ErdemWilkinson/makeshift-flipper/CAPABILITY_AND_THREAT_ASSESSMENT.md

# Makeshift Flipper: Capability, Use-Boundary, and Added-Component Impact Assessment

**Date:** 2026-09-21  
**Scope:** This document is a design and compliance assessment based on the
single-MCU ESP32-C6 firmware (UI + on-chip Wi-Fi/BLE radio) and the existing
hardware plans in this repository. It is not legal advice or an on-device
validation report.

> **Architecture note (2026-09-23):** The device was previously a two-chip
> design (ESP32-P4 main MCU + ESP32-C6 radio companion over UART). It is now
> a single ESP32-C6 running both the UI and the radio directly. References
> below to "the P4", "the C6 companion", or "the P4↔C6 UART link" describe the
> superseded design; in the current build those are one chip with no inter-MCU
> link, which removes the UART-boundary and cross-MCU-trust risks noted in
> those places rather than adding new ones.

## How to read this document

A capability is not inherently “legal” or “illegal.” The relevant factors are
authorization, purpose, data, target system, and local law. The
**inappropriate or potentially unlawful use** columns below are not feature
specifications or usage instructions. They record product risks and the
controls that should be put in place.

For this assessment, “authorized use” means at least:

- Owning the hardware, account, card, remote, or network, or having the
  owner's explicit and recorded permission;
- Defining the scope, timing, and data of a test in advance;
- Complying with personal-data, communications-privacy, access-control, and
  radio regulations;
- Sharing findings and logs only with authorized people and under secure
  retention conditions.

> **Validation warning:** Most features present in the code have not been
> validated on physical hardware. The firmware builds clean for the ESP32-C6,
> but the hardware has not been assembled — the ST7789 display wiring, the
> shared SPI bus, the RIGHT-button/I2C-SDA sharing, and Wi-Fi+BLE coexistence
> are all unverified. Therefore, “present” below means in code/design scope,
> not “working.”

## Six attention-worthy dual-use features

These are the six features most likely to make the device interesting to
makers, home-automation users, and authorized security testers. The last
column records the **unauthorized-use risk**, not a capability to promote or
implement. Hardware presence means “in the documented design”; it is not an
on-device success claim.

| Highlight | Legitimate, compelling use | Hardware/software basis | Unauthorized-use risk | Safe product framing |
|---|---|---|---|---|
| 1. Universal remote backup | Learn and replay an owner's compatible NEC TV, air-conditioner, or media remote from one handheld library | IR receiver, IR LED/transistor, NEC decoder/encoder, NVS library | Controlling compatible appliances without the owner's permission | “Your remotes only”; explicit send confirmation and visible transmit indicator. |
| 2. Test-card cloning lab | Demonstrate why weak MIFARE Classic default keys are unsafe, and back up owned training/test cards | RC522 reader/writer and constrained MIFARE Classic clone flow | Reusing an access credential to attempt unauthorized physical entry | Test cards and written authorization only; no persistent card dumps by default. |
| 3. Pocket wireless site survey | See nearby authorized Wi-Fi APs and BLE advertisers, with signal and channel information | On-chip ESP32-C6 Wi-Fi/BLE radios, passive monitor/scan UI | Collecting or profiling nearby networks/devices where there is no authority | Receive-only, short-lived display, no raw identifier saving by default. |
| 4. Offline field diagnostics | Carry errors and module status on-device for local debugging | On-device rolling error history (NVS) | Retaining scan/card data about people or networks with no authorization | On-device only; the old LAN log export is not part of the standalone build. |
| 5. No-phone Wi-Fi onboarding | Join an owned network by scanning and entering a password with the joystick keyboard, without a built-in keyboard | On-chip Wi-Fi STA scan + connect, display, joystick text entry | Mishandling or exposing credentials in an insecure/unauthorized setup environment | Local entry only; the old web-based Setup AP is not yet in the standalone build. |
| 6. Freed lab/TinyML platform | The former P4 main MCU is now free for a separate OCR/voice TinyML project, not carried in the field | (separate project; not this firmware) | Covert image/audio collection if a hostile build removes consent/indicators | Kept out of the field device entirely; evaluated in its own project. |

## Logical capabilities of the current device

| Area | Authorized and legitimate use in the code/design scope | Inappropriate or potentially unlawful-use risk | Built-in limit / status |
|---|---|---|---|
| 125 kHz RFID reading | Inventorying owned EM4100 tags; lab asset tracking; compatibility testing | Collecting another person's card identifier without authorization or targeting access control | The RDM6300 is read-only. |
| 13.56 MHz NFC / MIFARE Classic | Inspecting an owned test/training card or authorized system; data recovery | Copying an access card to attempt unauthorized physical entry | RC522; focused on 4-byte UIDs. The 7/10-byte UID flow is incomplete/incompatible. |
| MIFARE Classic cloning | Backing up owned test cards; checking weak default keys in a security lab | Bypassing access, billing, or identity controls by copying a card | Reads sectors accessible with its default-key dictionary; target card trailer blocks are not written. This technical limit does not remove the authorization requirement. |
| IR learning and NEC transmission | Backing up an owned TV/air-conditioner remote; home automation; IR receiver/transmitter testing | Controlling another person's device without permission or disrupting service | NEC-focused; at most 16 NVS records. |
| IR direction finding | Roughly measuring the coverage/placement of an owned IR emitter or remote | Monitoring another person's remote-control activity without authorization | Present in code but disabled because of RMT/GPIO conflicts; it is not precise location tracking. |
| Wi-Fi scanning | Coverage/channel inventory on an owned network; authorized wireless site survey | Collecting neighboring SSID/BSSID data outside the stated purpose or profiling | Via the C6; a UART parsing issue for result text is recorded. |
| Passive Wi-Fi monitoring | Viewing owned AP beacon/probe responses, channel, and security mode | Observing nearby device/network activity without permission or creating personal-data profiles | Receive-only; no deauth or packet injection in the design. The C6 is unverified. |
| Passive BLE scanning | Discovering owned BLE devices; advertisement-visibility testing | Tracking people or movement from device address/name/RSSI | Does not connect, access GATT, or support classic Bluetooth. |
| Wi-Fi setup | Connecting the owner's device to the owner's network; offline joystick-based setup | Connecting to a network not owned or authorized by the user | The temporary WPA2 AP password is generated per session; setup HTTP is not TLS-protected. |
| Error log / LAN transfer | Moving diagnostics from an owned device to a local PC | Unnecessary collection or insecure sharing of card/network-use traces | 24 RAM entries; optional PC server uses unauthenticated plain HTTP. |
| Local data libraries | Storing owned IR codes and authorized tag identifiers | Persistently retaining identifiers or radio data belonging to others | IR/RFID libraries use NVS; data becomes a risk if the device is lost. |

## What the current software explicitly does not do

The repository design does not include, or explicitly excludes, these
higher-risk behaviors:

- Wi-Fi deauthentication, management-frame injection, or attack traffic;
- Wi-Fi password cracking, password capture, or unauthorized network-access
  automation;
- BLE connections, pairing, GATT read/write, or classic Bluetooth scanning;
- General-purpose RFID card emulation; writing on the 125 kHz side;
- Writing card trailer blocks; this reduces card-lockout risk;
- Camera, audio recording, OCR, or voice-command runtime integration;
- Remote control, cellular networking, GPS/GNSS, or Sub-GHz radio.

These absences are not a security guarantee: MIFARE Classic cloning, IR replay,
and wireless-environment observation can still cause harm in an unauthorized
context.

## High-risk capabilities intentionally excluded from the product

The hardware platform could be changed by a third party, like any
general-purpose embedded system. The following capabilities are often
marketed as attention-grabbing "multi-tool" features, but they are **not
implemented, planned, or supported** in this repository. They are listed here
to make the project boundary explicit, not as a usage or implementation guide.

| Excluded capability | Why it is high risk | Product position | Safe, authorized alternative |
|---|---|---|---|
| Wi-Fi deauthentication / disassociation | Can intentionally disconnect people and devices from a network and disrupt service | Prohibited; no management-frame injection exists in this project | Passive channel/AP inventory on a network you administer |
| Rogue access point or captive-portal impersonation | Can mislead users into joining a fake network and expose credentials or traffic | Prohibited; setup AP is limited to configuring the owner's device | Use the documented owner-managed setup flow with a unique session password |
| Wi-Fi credential capture, cracking, or password attacks | Targets access credentials and can enable unauthorized network entry | Prohibited; no capture, handshake-collection, or cracking workflow exists | Audit the owner's Wi-Fi configuration and use strong WPA2/WPA3 credentials |
| Active Wi-Fi packet injection or disruptive probing | Can alter nearby network behavior, degrade service, or interfere with other users | Prohibited; monitor mode is receive-only by design | Perform passive site surveys and inspect the owner's AP configuration |
| BLE spoofing, pairing attacks, or GATT access | Can impersonate, track, or access another person's BLE device/data | Prohibited; BLE support is advertisement-only and never connects | Passive visibility testing for devices you own |
| General RFID/NFC emulation or payment/access-card bypass | Could imitate credentials or undermine physical-access and payment controls | Not implemented and outside product scope | Test owned training cards and document system weaknesses through authorized channels |
| RF jamming or high-power transmission | Can interfere with communications, safety systems, and regulated spectrum use | Strictly prohibited; no jamming or external high-gain RF design is included | Receiver-first measurements in a controlled, regulation-compliant lab |
| USB HID injection or malicious peripheral behavior | Can issue unwanted commands to a connected computer or collect data | Not implemented; USB should remain limited to approved update/data-transfer roles | Signed firmware updates and an explicitly selected data-export mode |
| Covert camera, microphone, or location tracking | Enables non-consensual collection of sensitive visual, audio, or location data | Not implemented; any future sensor design needs hardware indicators and explicit consent controls | Visible, user-initiated accessibility or lab features with no default recording |

These boundaries are part of the product identity: the project is intended to
be technically interesting because it integrates multiple local peripherals
and an on-chip radio on a single MCU, not because it disrupts, impersonates, or secretly
collects data from other people or systems.

## If a component is added: likely capabilities and boundaries

This table is not a purchasing or implementation plan. Each row also states
the authorization, indicator, and data-protection controls that should become
product requirements if the component is added.

| Potential added component | Legitimate value | Inappropriate or potentially unlawful risk | Safe product boundary |
|---|---|---|---|
| OV2640/similar camera + OCR | Offline reading of text on an owner's document, label, or device display; accessibility | Collecting images of people, documents, screens, or plates without consent; retaining sensitive data | Physical camera indicator, no-recording default, clear preview/consent, and storage disabled by default. |
| I2S microphone + Turkish command model | Hands-free operation and accessibility for the owner | Recording ambient conversations without consent or creating voice profiles | Push-to-talk/hardware mute, visible recording indicator, no raw-audio storage, and only a constrained command vocabulary. |
| microSD / encrypted external storage | Authorized test evidence and user backup | Bulk collection of personal data, card dumps, or environment scans; disclosure after device loss | Encryption, automatic retention expiry, export confirmation, and no default retention of sensitive dumps. |
| RTC + secure logging | Auditable timestamps for authorized tests | Long-term tracking of people or network movement | Short retention, visible log screen, and user-controlled deletion. |
| GNSS/GPS | Coverage mapping or asset location for an owner's field work | Tracking a person or vehicle without authorization | Explicit user start, continuous on-screen location indicator, and history disabled by default. |
| USB-C data interface | Firmware updates and secure export of the owner's logs | Malicious USB behavior, unauthorized data collection, or turning into a harmful peripheral | User-selected signed firmware and a restricted data class; no automatic keyboard/network-device modes. |
| Secure element | Device identity, encrypted settings/logs, and signed updates | Does not add an attack capability by itself; poor key management can cause data loss | Never export keys; define a recovery process and signed-update policy. |
| More capable NFC reader/emulator | Compatibility and security testing of an owned card system | Trying to imitate access-control credentials | Restrict emulation to test cards, require an on-device “authorized test” confirmation and audit record; do not support production access cards. |
| Sub-GHz receiver/transmitter | Lab analysis and protocol compatibility for an owner's remote/sensor | Unauthorized remote replay, interference, or unlawful transmission | Not recommended for this project; if added, allow only regulation-compliant bands/power, receiver-first design, and visible transmission approval. Jamming is strictly out of scope. |
| LTE/LoRa/remote connectivity | Owner status notifications or locating a lost device | Remote surveillance, covert tracking, or unauthorized remote control | Disabled by default, end-to-end authentication, visible pairing, and no remote radio/access feature by default. |
| External antenna / high-gain RF hardware | Authorized laboratory measurement | Longer-range unauthorized collection/transmission and radio-regulation violations | Do not add to the portable product; if required, use only in a controlled, regulation-compliant laboratory setup. |

## Design decisions that keep the product oriented toward legitimate use

1. **Authorization declaration and target verification:** Before actions such
   as cloning, IR transmission, and log export, use a short clear confirmation:
   “I have authorization for this target.” This does not replace legal
   permission, but reduces accidental misuse.
2. **Passive by default:** Keep Wi-Fi/BLE receive-only. Do not include packet
   injection, deauth, password attacks, jamming, or covert-tracking features
   in the product scope.
3. **Data minimization:** Disable persistent storage of Wi-Fi/BLE results and
   card dumps by default; remove it at session end unless the user explicitly
   saves it.
4. **Protection for sensitive records:** Encrypt IR codes, UIDs, and error logs
   held in NVS or microSD; authenticate USB/LAN exports. The existing plain
   HTTP log server is only acceptable on an isolated development LAN.
5. **Visibility:** A camera, microphone, location, or transmission feature
   must not run without a physical LED/icon and deliberate user initiation.
6. **Cloning safeguards:** The MIFARE Classic cloning screen should clearly
   state its authorization requirement, use short-lived memory, avoid
   persistent dumps, and not position production access-card copying as a
   product purpose.
7. **Secure updates:** Use signed firmware, rollback protection, and visible
   versioning. Otherwise, a third party could alter the device's environment-
   interaction capabilities for misuse.
8. **Field validation:** Do not claim any capability “works” until it has
   passed real-hardware testing and user acceptance using
   `HARDWARE_TEST_MATRIX.md`.

## Priority compliance and security work for this revision

1. (No longer applicable in the standalone build: the web-based Wi-Fi Setup
   AP and the plain-HTTP error-log endpoint are not part of it. If either is
   ported back, add authentication and encryption first.)
2. Keep sanitizing untrusted SSID/BLE-name text on screen (control/comma/CR/
   LF stripped) so a hostile name can't corrupt on-device rendering; the old
   UART-boundary version of this risk is gone with the wire protocol.
3. Add a prominent authorization warning, short-lived memory usage, and action
   logging to the NFC cloning flow; do not present cloning production access
   cards as a product goal.
4. Document retention and export rules for passive Wi-Fi/BLE results.
5. Turn the privacy controls above into hardware and software requirements
   before adding a camera, microphone, GNSS, or remote connectivity.

## Malicious acquisition: systematic threat model

It is not possible to enumerate “everything” in an absolute sense: an attacker
can alter physical hardware, firmware, and the connected computer. At that
point, this device can expand like any general-purpose ESP32-based platform.
The record below separates **real capabilities visible in the current
repository** from **transformations that require additional components and/or
firmware changes**. It is a risk inventory, not an attack method, code sample,
frequency plan, or access-bypass guide.

### A. Misuse classes possible with the unmodified current design

| Threat class | Existing device basis | Potential harm | Prerequisite / important limit | Mitigation |
|---|---|---|---|---|
| Physical access-card misuse | RC522 MIFARE Classic read/write and limited cloning | Unauthorized entry to an area; disclosure of card data | The target must be a supported type and its accessible sectors must be readable with available keys; it does not cover every card type | Restrict cloning to a test-card mode, show explicit authorization warning, do not retain dumps, and use a device lock. |
| Identifier inventory / profiling | RFID UID reading and NVS library | Collecting card identifiers that can be linked to people/assets | Requires close physical proximity and a supported card | Default to no saving, encrypt storage, set retention expiry, and log access. |
| Physical-device control | IR learning and NEC replay | Turning another person's compatible IR device on/off/changing it without permission | Requires line of sight, NEC compatibility, and a learned/valid code | Require clear confirmation before transmit, lock screen, encrypt IR codes, and use physical policies in managed environments. |
| Nearby-network discovery | Wi-Fi scan/monitor and BLE advertisement scan | Network/live-device inventory; time-and-place profiling | Device must be within radio range; the design does not perform active attack/connection | Session indicator, automatic cleanup, BSSID/MAC masking, and an authorized-site profile. |
| Privacy violation | Visibility of SSID, BSSID, BLE address/name, and RSSI; error logging | Inference about nearby people, devices, or networks | Passive data can still be personal data; risk rises when combined with time/location | Saving disabled by default, short retention, export confirmation, and staff training. |
| Local-network data disclosure | Sending error logs to a PC over plain HTTP | Exposing context about card/network/BLE use to third parties on the network | Requires the same LAN and an open/unprotected log server | Disable in production; use TLS, authentication, narrow network access, and encrypted logs. |
| Content disclosure after device compromise | IR/RFID library in NVS and diagnostic data in RAM/NVS | Taking or deleting saved remote/UID data | Requires physical access and appropriate debug/firmware access; specifics depend on device configuration | Secure boot/flash encryption, user PIN, signed firmware, and secure deletion. |
| Denial of service / loss of reliability | C6 sessions and recorded protocol/task bugs | Setup, scan, or logging can lock up/restart | The recorded software defects must be triggerable; field validation status varies | Resolve `KNOWN_ISSUES.md` findings, add regression tests, watchdogs, and health screen. |

### B. Classes a malicious holder could create by changing hardware or firmware

| Transformation | Added item | Potential misuse effect | Present in this repository today? | Design/procurement policy |
|---|---|---|---|---|
| Covert visual collection | Camera + recording/transmission firmware | Non-consensual image collection, public-space surveillance, or document/screen capture | No; camera/OCR is planning only | Hardware-wired camera LED, lens cover, no-recording default, and user confirmation before export. |
| Covert audio collection | Microphone + continuous-recording firmware | Non-consensual conversation recording or voice profiling | No; only a limited command classifier is planned | Hardware mute, push-to-talk, recording LED, and no raw-audio storage. |
| Location tracking | GNSS and/or remote connectivity | Tracking a person/vehicle | No | Default-off location history; visible user pairing for remote access. |
| Broader radio misuse | Sub-GHz, high-gain antenna, or additional RF module | Unauthorized remote interaction, longer-range collection, or unlawful transmission | No | Do not include these components in the base product; treat jamming and active interference as prohibited. |
| Broader NFC emulation | Different NFC hardware and custom firmware | Attempting to imitate access/identity systems | No; current design provides no general card emulation | Test-environment profile only, signed firmware, and exclusion of production-card functionality. |
| Remotely controlled surveillance device | LTE/LoRa/internet client + backend | Remote device control, telemetry collection, or covert data exfiltration | No; the current C6 is designed for local functions | Internet egress off by default, end-to-end authentication, and explicit visible user pairing. |
| Peripheral-attack device | USB host/gadget, additional adapters, and new firmware | Unauthorized interaction with connected computers/devices or data collection | No; the repository has no such user feature | Restrict USB to signed updates and approved data transfer. |
| Persistent malicious-firmware platform | Debug access, reflashing, or supply-chain tampering | Hiding the above behaviors behind apparently benign features | A design risk; secure boot/flash encryption are not documented safeguards yet | Secure boot, flash encryption, signed/visible-version firmware, and manufacturing key procedures. |

## Component-by-component capability and misuse suitability register

This section exists to state one thing plainly, component by component: the
hardware already in this design is generically capable radio/IR/RFID
hardware, and the *only* thing standing between it and a higher-risk
capability is which firmware runs on it. That is true of nearly all embedded
radio/sensor hardware, not a defect specific to this project, but it is
stated explicitly here rather than left implicit. Two patterns repeat below:

- **"This part is already in the design. Replacing the firmware that drives
  it could enable: ..."** — for hardware already installed/documented in
  this repository.
- **"Adding this part would newly enable: ..."** — for hardware not present
  today, where adding it is what changes the threat surface, not firmware
  alone.

None of this is an implementation guide, and a listed illegal use is never
something this project's own firmware does — see the "does not do" and
"claims not supported" sections above for what the actual shipped code
implements. A capability being technically plausible with different firmware
does not make it lawful, reliable, or possible against every target:
physical testing, protocol support, range, credentials, and law remain real
constraints on top of everything below.

### Installed or documented current components

**ESP32-C6 main MCU (single chip)** — runs the local UI, input, IR,
RFID/NFC, diagnostics, AND the Wi-Fi/BLE radio, all on one chip.
*Already in the design; different firmware on it could enable:* combining
multiple sensors' results, retaining them against the owner's intent, or
silently disabling the confirmation/authorization screens this project's own
firmware shows before a clone/transmit/scan action — turning an
authorized-use tool into a covert collection/control device coordinating
whatever else is attached. Because the radio now lives on the same chip,
this MCU also carries the RF risks listed below directly.
*Limit:* only this repository's firmware choices keep the radio receive-only;
the silicon supports more.
*Required boundary:* secure boot, flash encryption, signed firmware, a user
lock, and a visible firmware version so a swapped image isn't invisible.

**On-chip Wi-Fi/BLE radio (same ESP32-C6)** — performs Wi-Fi scan/monitor
and BLE scanning today, receive-only by design.
*Already in the design; different firmware on it could enable:* active
Wi-Fi deauthentication/injection, credential capture, BLE pairing/GATT
access, or classic Bluetooth scanning — none of which the current C6
firmware implements, but the chip itself supports all of them at the
silicon level; only this repository's firmware choices keep it
receive-only.
*Limit:* C6 is Wi-Fi + BLE only, no cellular/Sub-GHz; range and
channel/firmware constraints still apply.
*Required boundary:* keep radios receive-only by policy (not just by
omission), authenticate any export, show an active-radio indicator, and
restrict to signed firmware.

**RC522 13.56 MHz reader/writer** — reads supported card UIDs and supports
a constrained MIFARE Classic test-card clone flow today (no trailer-block
writes, default-key dictionary only).
*Already in the design; different firmware on it could enable:* writing
trailer/access-control blocks (this project's firmware deliberately never
does), full-sector cloning against any card whose keys are known/weak, or
building a persistent library of scanned card data without the owner's
knowledge — turning "read my own test card" into "harvest and reuse access
credentials belonging to others."
*Limit:* limited card family/flow; 7/10-byte UID support is incomplete;
this is not payment-card copying or universal NFC emulation, regardless of
firmware.
*Required boundary:* test-card-only product positioning, no persistent dump
by default, explicit authorization confirmation, encrypted storage.

**RDM6300 125 kHz reader** — reads EM4100-family tag IDs, read-only
hardware.
*Already in the design; different firmware on it could enable:*
non-consensual collection and silent retention of nearby compatible tag
identifiers (e.g. logging every badge that passes near the device instead
of only the one the user intentionally scans).
*Limit:* read-only at the hardware level; short range; no tag
writing/emulation is possible on this chip regardless of firmware.
*Required boundary:* do not persist identifiers by default; encrypt any
retained inventory; apply retention limits.

**IR receiver (VS1838B class)** — learns compatible NEC remote codes from
an owned remote today, only on explicit user action.
*Already in the design; different firmware on it could enable:*
continuous/background capture of every IR command in range instead of only
a deliberately learned one — e.g. silently logging a household's remote
usage.
*Limit:* requires a compatible protocol and optical line-of-sight
reception; it is not a general RF receiver.
*Required boundary:* require clear capture indication and consent; avoid
automatic persistent saving.

**IR LED transmitter + transistor** — replays approved NEC codes to an
owned appliance today, only on explicit confirmation.
*Already in the design; different firmware on it could enable:*
unattended/scheduled/remote-triggered transmission of learned codes at
another person's device — e.g. repeatedly toggling an appliance in a space
the user doesn't control, or nuisance operation of a compatible
line-of-sight device.
*Limit:* requires line of sight, a compatible code, and limited physical
range; no universal-remote guarantee regardless of firmware.
*Required boundary:* physical transmit indicator, deliberate confirmation
per action, device lock, no unattended schedule/remote trigger.

**Four-receiver IR direction board concept** — present in source
(`ir_direction.c`) but disabled in the shipped build (RMT/GPIO resource
conflict, not a policy choice alone).
*Already in the design (dormant); enabling + different firmware could
enable:* roughly tracking which direction a remote is being operated from
inside a space the user doesn't control — a coarse but real
physical-surveillance use, not just IR replay.
*Limit:* disabled today; even enabled, this is coarse direction-finding,
not precise location tracking.
*Required boundary:* keep disabled until there's a legitimate tested use
case and a visible-use control; re-enabling it is itself a decision that
needs this document revisited.

**C6 Wi-Fi radio** — authorized AP scan, owner-managed setup, and
receive-only channel-hopping monitor today.
*Already in the design; different firmware on it could enable:*
deauthentication/disassociation attacks, active packet injection, WPA
handshake capture for offline password cracking, or rogue-AP/captive-portal
impersonation to harvest credentials — none implemented today, all
technically reachable by firmware alone on this radio.
*Limit:* current code excludes all of the above; radio range and
channel/firmware constraints still apply regardless.
*Required boundary:* keep receive-only by policy, not just by omission;
default to short-lived data; BSSID masking; site-authorization mode; no
active-attack code path ever merged.

**On-chip BLE radio** — passive advertisement discovery of nearby BLE
devices today, never connects.
*Already in the design; different firmware on it could enable:* active
connection, pairing/bonding attacks, GATT read/write against a target
device, or classic-profile impersonation — this chip's BLE stack supports
connecting; only this repository's firmware choice keeps it advertisement-
only.
*Limit:* passive-only code today; no classic Bluetooth (chip limitation,
firmware-independent).
*Required boundary:* do not retain raw addresses by default; visible scan
state; export approval required.

**(Removed) P4↔C6 UART link** — in the two-chip design this was a wired
command/result channel between the P4 and the C6. The single-MCU build has
no such link: the UI and the radio are the same chip and call each other as
in-process functions.
*Effect on risk:* the old cross-MCU risks — passing surveillance data
between two processors invisibly, or one side disabling the safety/
confirmation state the other enforces — no longer apply, because there is
no second processor and no wire to desynchronize. The UI code and the radio
code share one address space; their consistency is a code-review property,
not a wire-protocol one.
*Required boundary:* keep the UI's confirmation/authorization gates in the
same firmware image that drives the radio, and cover them in review.

**NVS persistent storage** — stores permitted IR/RFID library entries and
device settings today, bounded (16-entry libraries, 24-entry error ring).
*Already in the design; different firmware on it could enable:*
unbounded, silent retention of every scanned identifier or learned code
instead of only what the user explicitly saved — turning a bounded local
library into an unlimited surveillance log that survives reboots.
*Limit:* flash capacity is limited; storage itself does not transmit data
off-device.
*Required boundary:* encrypt at rest, require user unlock, provide secure
erase, make retention opt-in.

**ST7789 display** — presents menus, warnings, confirmation screens, and
results today.
*Already in the design; different firmware on it could enable:* removing
or faking the authorization-confirmation screens this project's own
firmware shows before sensitive actions, or showing a deceptive/blank
screen while a hidden action runs in the background — social engineering
through a UI the user trusts.
*Limit:* output-only; the display itself adds no sensing or transmission
capability.
*Required boundary:* hardware-tied privacy/radio LEDs for sensitive
functions (not just an on-screen icon a hostile firmware could omit); show
signed firmware identity at boot.

**Joystick and BACK button** — local, deliberate device navigation.
*Already in the design; different firmware on it could enable:* mapping an
innocuous-looking button combination to a hidden, undisclosed action (e.g.
a "secret" long-press that starts a background scan/transmit with no UI
indication).
*Limit:* no independent communication or sensing capability of its own.
*Required boundary:* clear action labels, confirmation for sensitive
operations, a lockout/PIN flow for anything irreversible.

**Vibration motor** — feedback after allowed scans/actions today.
*Already in the design; different firmware on it could enable:* covert
haptic signaling to an operator holding the device out of sight (e.g. a
distinct buzz pattern meaning "found a compatible card") — a real if
low-severity covert-channel use.
*Limit:* cannot itself collect, transmit, or control a target.
*Required boundary:* keep haptics paired with visible UI state; avoid
silent background actions that also buzz.

**Setup SoftAP + HTTP form** — lets the owner provide Wi-Fi credentials
without a keyboard today, plaintext HTTP with a per-session WPA2 password.
*Already in the design; different firmware on it could enable:* a
credential-harvesting captive portal presented as if it were the legitimate
setup flow, since the current transport already lacks TLS — a modest
firmware change turns an onboarding convenience into a phishing surface on
the local network.
*Limit:* requires the attacker to be on/observing the setup network at the
right moment; not a remote attack.
*Required boundary:* replace with authenticated encrypted transport, or
limit to a controlled setup environment; disclose credential handling
plainly to the user.

**PC-side debug log collector** — an optional, local-network diagnostic
upload tool.
*Already in the design; different firmware/server config could enable:*
exfiltrating a device's full usage history (which cards were scanned, which
networks/BLE devices were seen) to an attacker-controlled or unsecured
host, since the existing transport is already unauthenticated plain HTTP.
*Limit:* optional, local-network-oriented, outside the handheld hardware
itself; requires the log server to be reachable.
*Required boundary:* mutual authentication, TLS, least-data export,
local-only default, audit trail.

**Power/battery and enclosure** — portable operation of the owner's
device.
*Already in the design; relevant to misuse only indirectly:* portability
itself is what makes any of the above easier to conceal or operate
unnoticed in a space the user doesn't control — it doesn't add a
capability, it makes existing ones more deployable covertly.
*Limit:* the power system adds no sensing, RF, or target-access capability
by itself.
*Required boundary:* physical kill switches for radios/camera/microphone;
tamper-evident enclosure choices.

### Components not present: additions that would newly enable an illegal capability

Every row below is hardware **not in this design today**. Adding it is what
changes the threat surface — in each case, the addition plus custom firmware
is what would newly make the listed illegal use technically plausible; the
device cannot do any of these today without the added part.

**Add a camera module (e.g. OV2640)** → newly enables: covert visual
surveillance — recording people, documents, screens, or license plates
without consent, especially easy to conceal in something already shaped
like an innocuous handheld.
*Legitimate reason to add it anyway:* offline OCR, accessibility,
owner-approved document/label capture (see `HARDWARE_INTEGRATION_PLAN.md`).
*Minimum restriction if added:* hardware-wired recording LED, physical
shutter/cover, no background capture, no default upload, storage disabled
by default.

**Add a microphone (e.g. I2S)** → newly enables: covert audio
recording — capturing ambient conversations or building a voice profile of
someone who never agreed to it.
*Legitimate reason to add it anyway:* push-to-talk command control and
accessibility for the owner.
*Minimum restriction if added:* hardware mute switch, push-to-talk only
(no always-listening mode), visible recording-state LED, no raw-audio
retention, constrained command vocabulary only.

**Add a GNSS/GPS receiver** → newly enables: location tracking and
movement profiling of a person or vehicle without their knowledge.
*Legitimate reason to add it anyway:* owner-authorized asset/field-work
location tagging.
*Minimum restriction if added:* default-off, continuous on-screen location
indicator whenever active, no history retained without explicit consent
each time.

**Add a cellular modem or other long-range data radio (LTE/LoRa)** →
newly enables: remote surveillance, telemetry exfiltration to a third
party, or a remote command-and-control channel operating outside the
owner's physical presence.
*Legitimate reason to add it anyway:* owner status alerts, recovering a
lost device.
*Minimum restriction if added:* disabled by default, end-to-end
authentication, visible pairing, no hidden background transport, an
emergency disconnect.

**Add a Sub-GHz transceiver** → newly enables: unauthorized replay of
garage-door/gate/car-fob and similar remotes, or transmission outside a
licensed/permitted band — a direct physical-security bypass class this
device cannot reach today (its only transmitter is a line-of-sight IR LED).
*Legitimate reason to add it anyway:* lab protocol-compatibility analysis
with the owner's own remotes/sensors.
*Minimum restriction if added:* receiver-first design, regulatory
band/power limits enforced in firmware, deliberate transmit confirmation
per action, jamming/active interference permanently excluded.

**Add a high-gain/directional antenna** → newly enables: collection or
transmission (Wi-Fi/BLE/Sub-GHz, whichever radio it's paired with) from
well outside the range any of this device's current radios reach —
turning a room-scale receive-only tool into a longer-range one, which
changes what "nearby-network discovery" or "IR/Sub-GHz replay" can reach
without the owner's knowledge.
*Legitimate reason to add it anyway:* controlled RF measurement in a lab.
*Minimum restriction if added:* keep out of the portable/consumer
configuration entirely; controlled-lab use only, never in a handheld form
factor.

**Add a more capable/general NFC front end or emulator** → newly enables:
imitating an access-control or identity credential well beyond RC522's
current MIFARE-Classic-with-known-keys limitation — a materially stronger
credential-forgery capability than anything present today.
*Legitimate reason to add it anyway:* authorized test-card and protocol
compatibility testing.
*Minimum restriction if added:* test-card-only firmware profile, secure
boot, on-device audit records, explicit exclusion of production/payment
credentials from the supported set.

**Add USB host/gadget capability** → newly enables: acting as a malicious
USB peripheral against a connected computer (keystroke injection, disguised
storage/network device) or pulling data off a host — an attack surface this
device has no path to today with no USB data role implemented.
*Legitimate reason to add it anyway:* signed firmware updates, approved
data export.
*Minimum restriction if added:* restrict to explicit signed-update and
approved-export roles only; disallow automatic HID/keyboard or
network-device modes entirely.

**Add external flash/microSD storage** → newly enables: bulk, large-scale
retention of scanned identifiers, card dumps, radio scans, or (if a
microphone/camera were also added) recordings — turning what's currently a
small, bounded on-device log (16-entry libraries) into an effectively
unbounded collection archive.
*Legitimate reason to add it anyway:* a larger offline archive for the
owner's own authorized test evidence.
*Minimum restriction if added:* encryption at rest, automatic retention
expiry, explicit export/save confirmation, no default retention of
sensitive dumps.

**Add a secure element** → does not by itself enable a new illegal
capability — included here because it's a common "security" addition that
gets asked about. A weak *implementation* of it could instead lock out the
legitimate owner (a different failure mode than misuse).
*Legitimate reason to add it anyway:* device identity, encrypted
settings/logs, signed-update verification.
*Minimum restriction if added:* protected manufacturing keys, a recovery
policy, a verified boot chain.

**Add an Ethernet/USB network adapter** → newly enables: an additional
data-exfiltration path from a physically connected device, beyond the C6's
existing Wi-Fi path — relevant mainly as a second, easy-to-overlook network
egress point once someone has physical access to the device.
*Legitimate reason to add it anyway:* controlled local management or
diagnostics.
*Minimum restriction if added:* disabled by default, authenticated
management only, an explicit network egress allowlist.

### C. Impact chains

This device is most readily turned into a harmful tool through one of the
following three chains. The chains show that risk comes not from a single
feature alone, but from combining observation with retention and export.

```text
Nearby-environment observation  -> identifier/radio metadata -> persistent storage -> export
RFID/NFC or IR interaction      -> unauthorized replay/reuse -> physical/device impact
Camera/microphone/GNSS added    -> sensitive-data collection -> remote export -> tracking/surveillance
```

The first chain is possible to a limited degree in the current design. The
second creates legal and security risk only when an unauthorized target/card/
remote is chosen. The third is not present in the current repository, but
arises once hardware, firmware, and transfer infrastructure are added.

### D. Claims that are not supported as current capabilities

It would be inaccurate to record the following as abilities of the current
device:

- Wi-Fi password capture/cracking, Wi-Fi packet injection, or deauth;
- BLE pairing compromise, GATT data reading, or connecting to devices;
- Credit-card/payment-card copying; this requires different technologies and
  lies outside the current RC522/MIFARE Classic flow;
- General RFID/NFC card emulation or copying every card type;
- Signal jamming, cellular interception, GPS tracking, camera/audio recording,
  or internet-based remote control;
- A claim that any feature has successfully worked on physical hardware.

These limits can change if new hardware, firmware, or external services are
added. The product's security model must therefore rely not only on today's
menu but also on signed firmware and a hardware-expansion policy.

## Source scope

- `README.md`: current modules, pin plan, operational limits, and security
  notes.
- `C6_STANDALONE_HARDWARE_PLAN.md`: single-MCU pin map, power tree, missing-
  parts BOM, and bring-up order.
- `KNOWN_ISSUES.md`: build/validation status and known security, reliability,
  and parsing issues.
