ErdemWilkinson/makeshift-flipper/YETENEK_VE_UYUM_DEGERLENDIRMESI.md

# Makeshift Flipper: Capability, Use-Boundary, and Added-Component Impact Assessment

**Date:** 2026-09-21  
**Scope:** This document is a design and compliance assessment based on the P4
main firmware, C6 companion firmware, and the existing hardware/AI plans in
this repository. It is not legal advice or an on-device validation report.

## How to read this document

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

For this assessment, “authorized use” means at least:

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

> **Validation warning:** Most features present in the code have not been
> validated on physical hardware. An initial P4 boot was observed with the
> earlier SSD1306 arrangement, but the current ST7789 display arrangement is
> unverified; C6 Wi-Fi/BLE end-to-end behavior is also unverified. Therefore,
> “present” below means in code/design scope, not “working.”

## Logical capabilities of the current device

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

## What the current software explicitly does not do

The repository design does not include, or explicitly excludes, these
higher-risk behaviors:

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

## High-risk capabilities intentionally excluded from the product

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

These boundaries are part of the product identity: the project is intended to
be technically interesting because it integrates multiple local peripherals
and a two-MCU architecture, not because it disrupts, impersonates, or secretly
collects data from other people or systems.

## If a component is added: likely capabilities and boundaries

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

## Design decisions that keep the product oriented toward legitimate use

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

## Priority compliance and security work for this revision

1. Disable the C6 Wi-Fi setup's plain HTTP and unauthenticated error-log
   endpoint in production, or replace them with authentication and encryption.
2. Fix the recorded Wi-Fi-name parsing issue that can break UART boundaries,
   using a lossless unambiguous protocol with explicit length/binary encoding.
3. Add a prominent authorization warning, short-lived memory usage, and action
   logging to the NFC cloning flow; do not present cloning production access
   cards as a product goal.
4. Document retention and export rules for passive Wi-Fi/BLE results.
5. Turn the privacy controls above into hardware and software requirements
   before adding a camera, microphone, GNSS, or remote connectivity.

## Malicious acquisition: systematic threat model

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

### A. Misuse classes possible with the unmodified current design

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

### B. Classes a malicious holder could create by changing hardware or firmware

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

### C. Impact chains

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

```text
Nearby-environment observation  -> identifier/radio metadata -> persistent storage -> export
RFID/NFC or IR interaction      -> unauthorized replay/reuse -> physical/device impact
Camera/microphone/GNSS added    -> sensitive-data collection -> remote export -> tracking/surveillance
```

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

### D. Claims that are not supported as current capabilities

It would be inaccurate to record the following as abilities of the current
device:

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

## Source scope

- `README.md`: current modules, pin plan, operational limits, and security
  notes.
- `c6-firmware/README.md`: P4–C6 protocol, passive monitor/BLE scan limits,
  and local error-log transfer.
- `HARDWARE_INTEGRATION_PLAN.md`: camera/OCR and microphone-command model in
  planning only.
- `KNOWN_ISSUES.md`: physical-validation status and known C6/P4 security,
  reliability, and parsing issues.
