ErdemWilkinson/makeshift-flipper/docs/images/3d-viewer-exploded.png

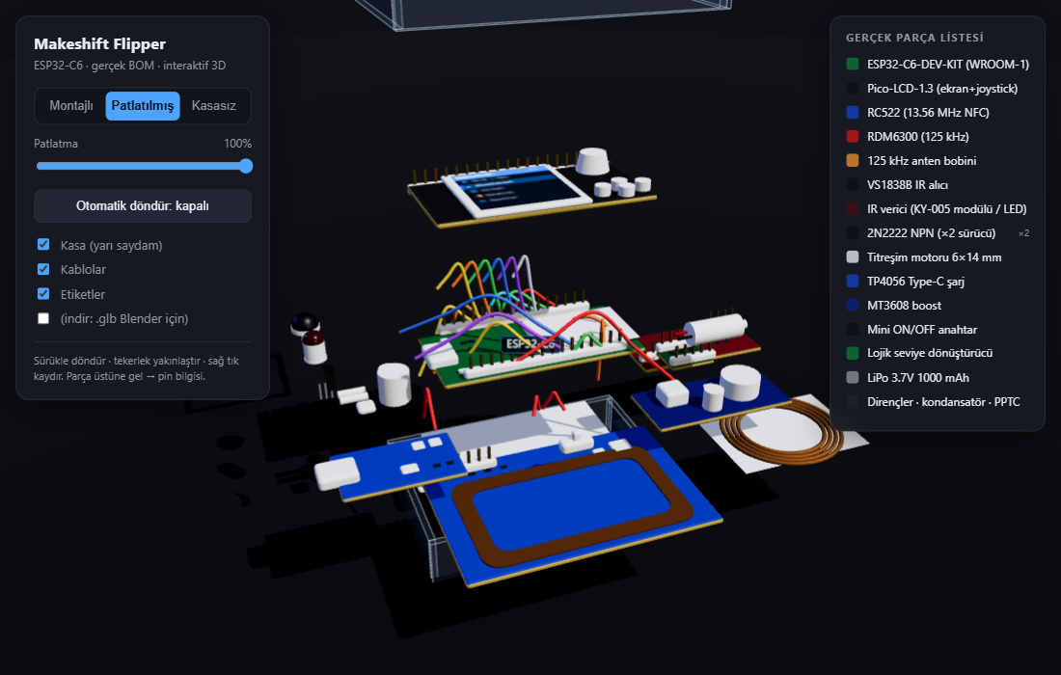
docs/images/3d-viewer-exploded.png
