ErdemWilkinson/makeshift-flipper/docs/images/compact-stack-exploded.png

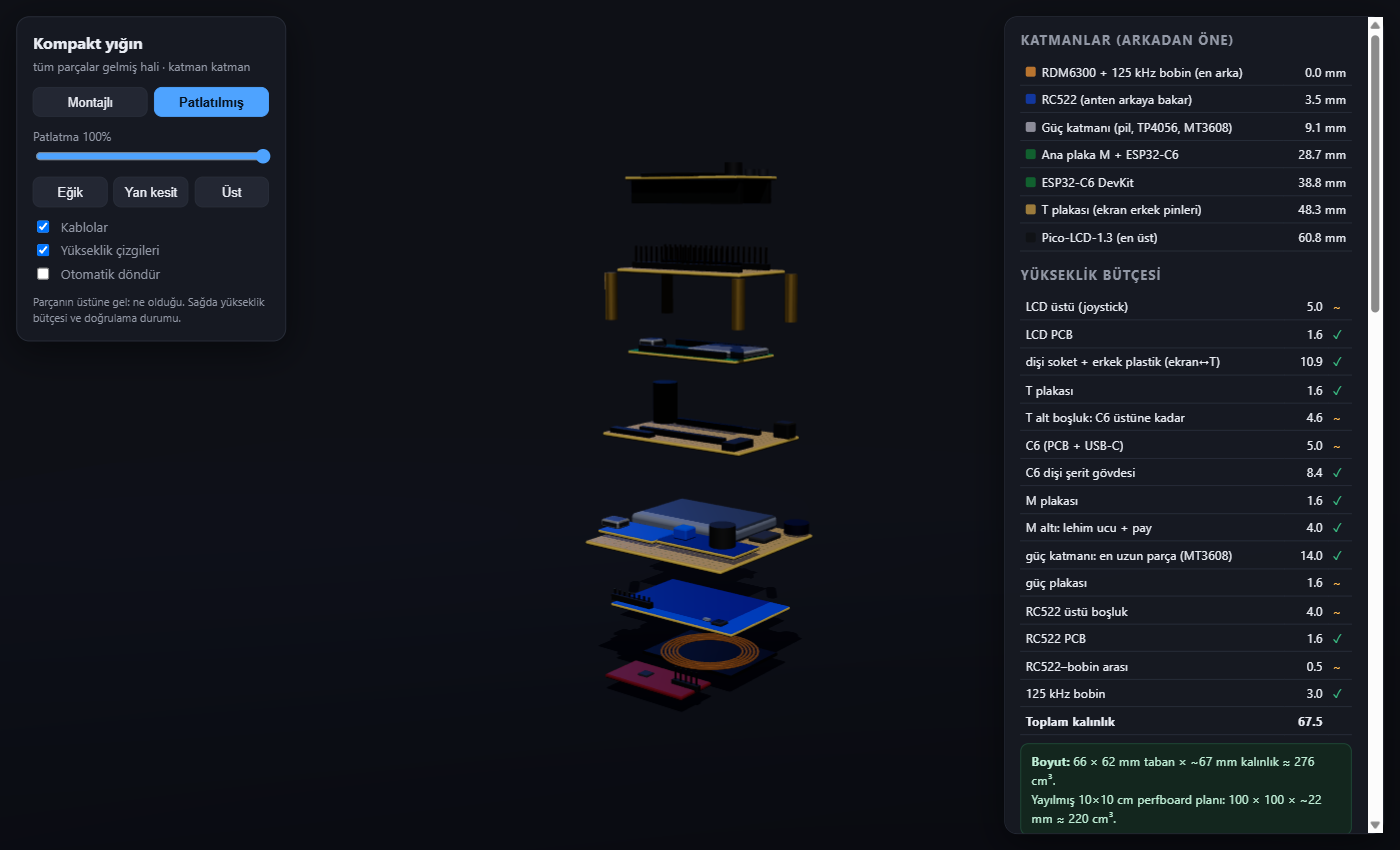
docs/images/compact-stack-exploded.png
