ErdemWilkinson/makeshift-flipper/docs/images/perfboard-plan.png

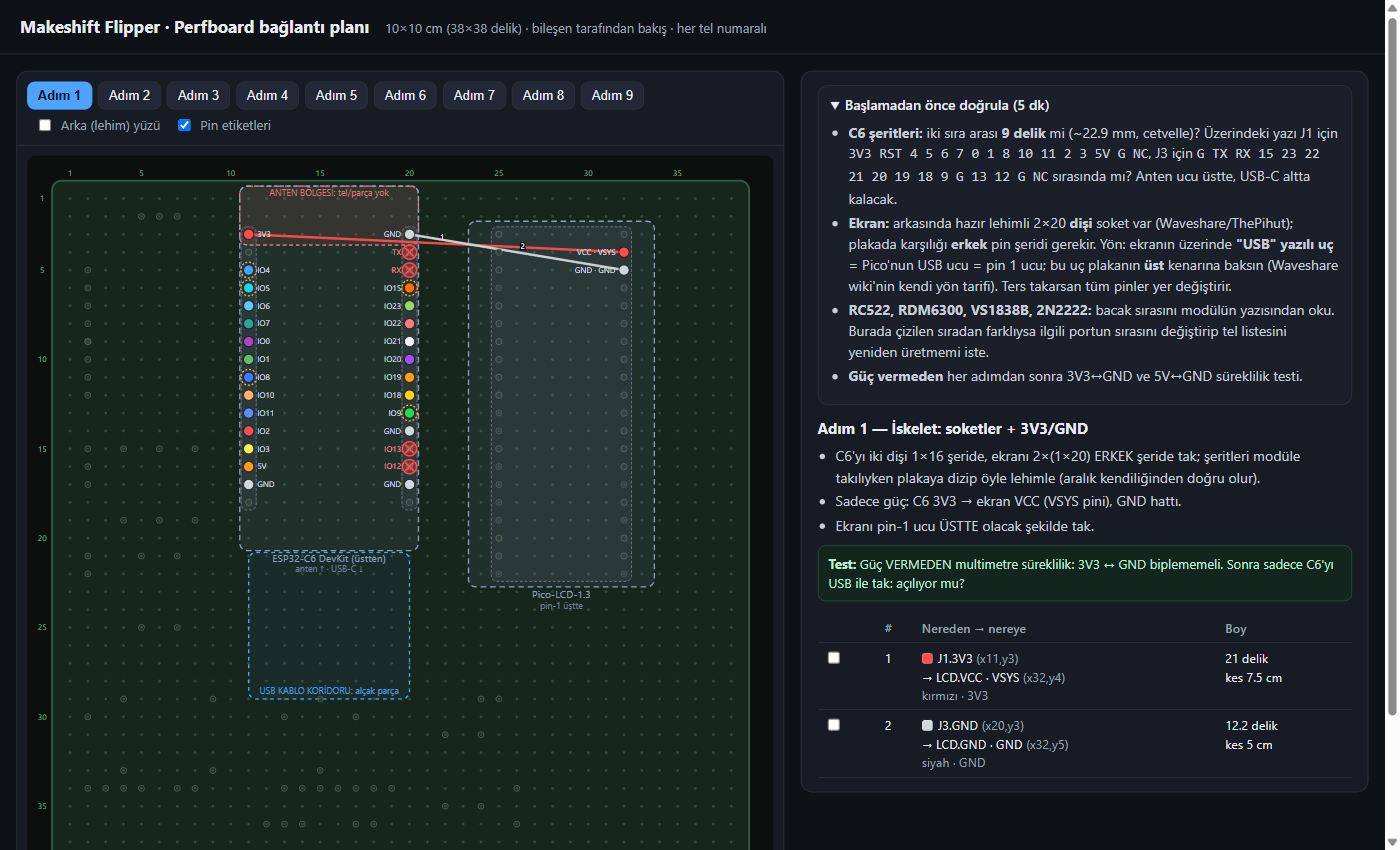
docs/images/perfboard-plan.png
