ErdemWilkinson/makeshift-flipper/docs/images/3d-viewer-assembled.png

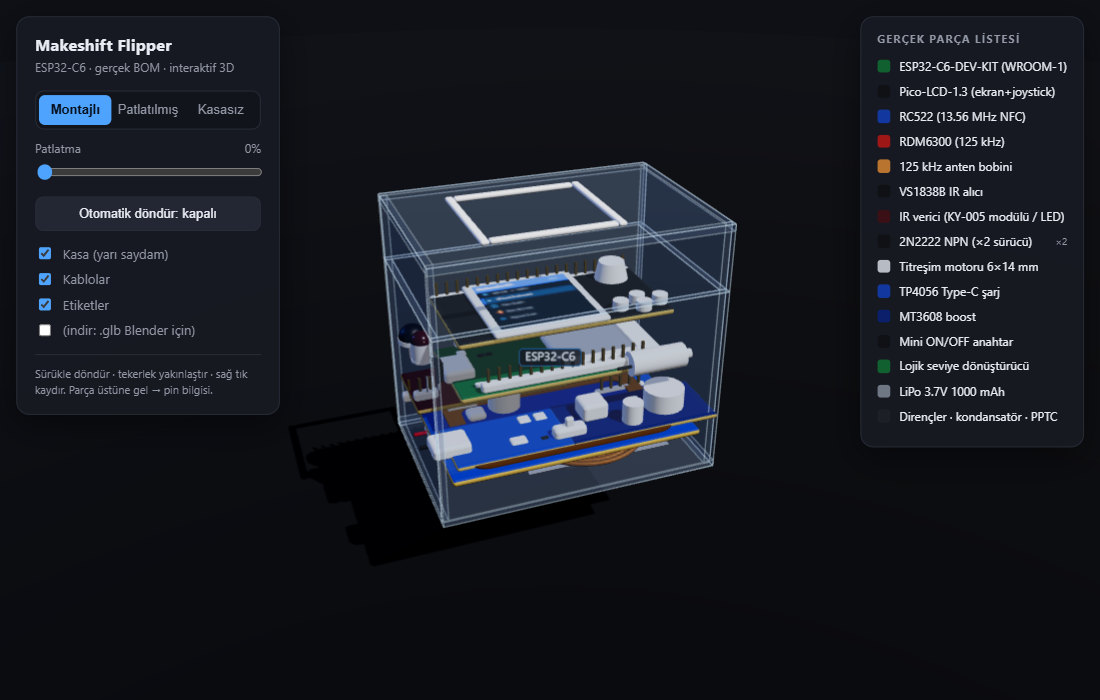
docs/images/3d-viewer-assembled.png
