ErdemWilkinson/makeshift-flipper/docs/images/compact-stack-assembled.png

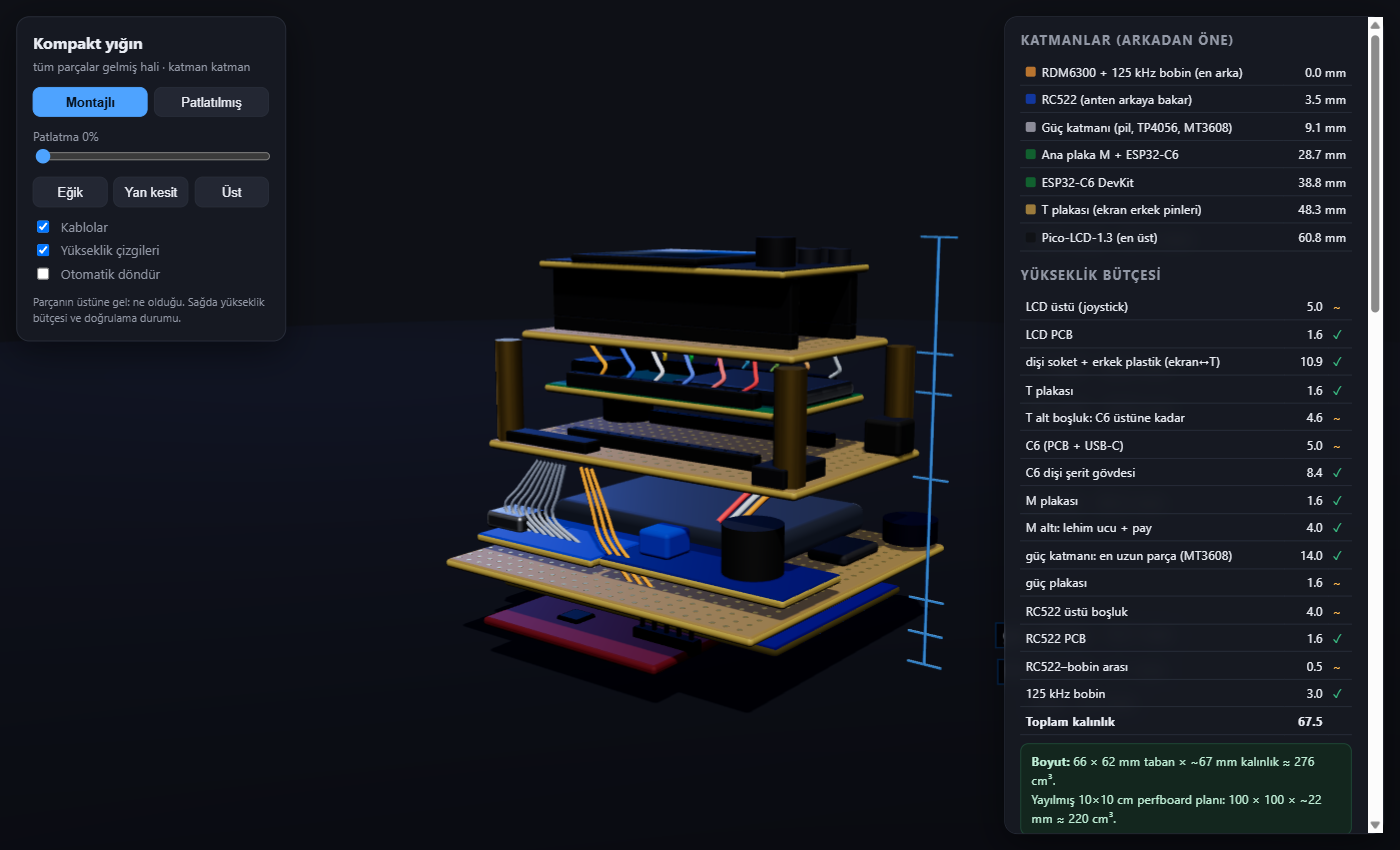
docs/images/compact-stack-assembled.png
