ErdemWilkinson/makeshift-flipper/docs/images/perfboard-plan-step7.png

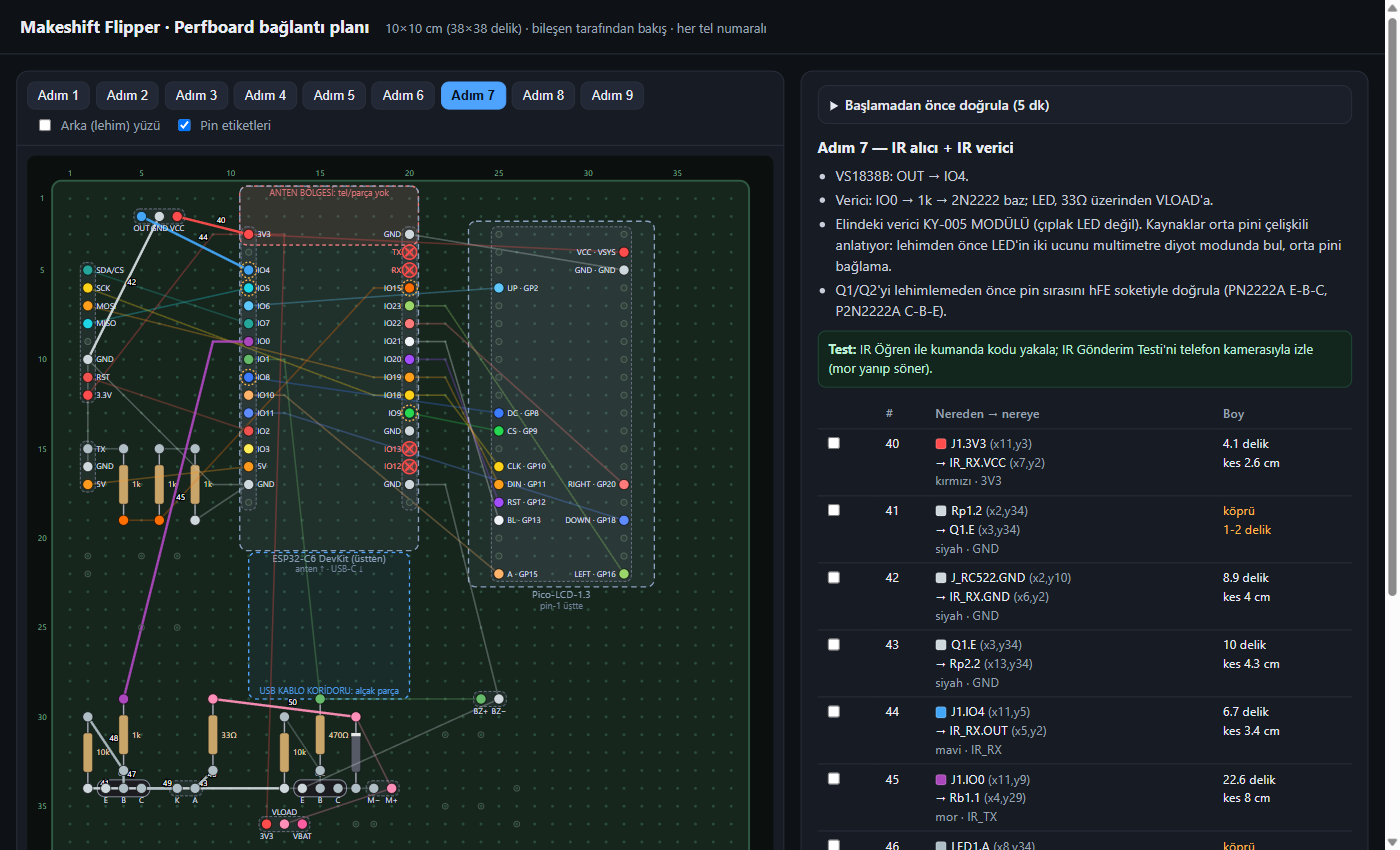
docs/images/perfboard-plan-step7.png
