ErdemWilkinson/makeshift-flipper/docs/hardware/HARDWARE_TEST_MATRIX.md

# Hardware test matrix

A checklist for verifying this device on real hardware, module by module,
after any firmware change that touches pins, the joystick, IR, RFID, or the
Wi-Fi/BLE radio. The current direct-button pin map is in `main/input/buttons.c`;
the older Pico/TCA9554 mapping in
[C6_STANDALONE_HARDWARE_PLAN.md](C6_STANDALONE_HARDWARE_PLAN.md) does not
describe the current ESP32-C6-DEV-KIT-NX carrier wiring.

**This matrix covers the single-MCU ESP32-C6 standalone build only.** The
former two-chip (ESP32-P4 + ESP32-C6-over-UART) design is retired; if you
find a row anywhere in this repo's history that references P4 GPIOs, an
analog ADC joystick, or a SoftAP-based Wi-Fi setup server, it describes that
retired design, not the current firmware — see
[KNOWN_ISSUES.md](../../KNOWN_ISSUES.md)'s Round 27 for how that mismatch was
found and fixed.

The single-MCU ESP32-C6 firmware builds under ESP-IDF v5.3.x and has been
flashed to a display/control prototype. Serial boot output and some controls
have been checked, but this does **not** validate every peripheral or radio
feature. Treat each row below as unverified until individually checked on
the device. Follow the bring-up order in
[C6_STANDALONE_HARDWARE_PLAN.md](C6_STANDALONE_HARDWARE_PLAN.md) (display +
buttons first, then RFID, IR, and last the power/battery chain).

How to use this: flash the firmware (`idf.py flash`), work through each row,
and record pass/fail plus any deviation (wrong pin, wrong polarity, timing
issue). Update the pin map or the relevant `.c` file's `#define`s if your
wiring differs — don't just work around it in your head.

## 1. Power-on and display

| Check | Expected | Pin(s) |
|---|---|---|
| Device boots without a crash loop | LCD shows the main menu | — |
| LCD renders text and colors cleanly, no garbled/mirrored pixels | Menu items readable, correct colors (not swapped R/B) | SCK=GPIO18, MOSI=GPIO19, CS=GPIO9, DC=GPIO8, RST=GPIO20 (shared SPI2 bus with RC522) |
| Colors are correct, not inverted (e.g. background isn't white when it should be black) | If colors look inverted, toggle `esp_lcd_panel_invert_color()`'s argument in `display_init()` -- this varies by panel batch | — |
| Display orientation looks right for your specific panel (not upside-down or mirrored) | If wrong, adjust `esp_lcd_panel_mirror()`/`esp_lcd_panel_swap_xy()` calls (not currently called -- add if needed) | — |
| Backlight turns on with the device | Screen is lit on power-up | LCD_BL_GPIO = GPIO21, driven high in `display_init()` |

## 2. Joystick and buttons

| Check | Expected | Pin(s) |
|---|---|---|
| UP moves the cursor up | Cursor moves | LCD GP2 -> C6 GPIO6 (current wiring) |
| PRESS (center) is not polled | A button (GPIO10) is the confirm key | GPIO3 is the battery ADC input, not a button |
| DOWN moves the cursor down | Cursor moves | LCD GP18 -> C6 GPIO11 (moved from GPIO2; disconnect B first) |
| LEFT backs out on ordinary screens | Returns to parent menu | LCD GP16 -> C6 GPIO23 |
| RIGHT enters/selects on ordinary screens | Menu action fires | LCD GP20 -> C6 GPIO22 |
| A selects; B is intentionally disconnected/disabled | A confirms; GPIO11 is used by DOWN | LCD GP15 -> C6 GPIO10; LCD GP18 -> C6 GPIO11 |
| Keyboard horizontal navigation | Short LEFT/RIGHT move one column; long LEFT exits, long RIGHT selects | GPIO23/GPIO22; A acts immediately |
| Text entry grid (`text_entry.c`, used by WiFi Tara/Bağlan's password screen) navigates and appends chars correctly | Matches `tests/test_text_entry.c`'s host-tested logic | via same button pins |

These are direct wires, not a completed hardware check. Verify the actual
carrier header labels and common GND before connecting them. UP is GPIO6 and
RC522 MISO is GPIO5 (`hardware_profile.h`), so they no longer collide;
`BOARD_HAS_RC522` stays 0 until the RC522 is physically wired.

## 3. Vibration motor

| Check | Expected | Pin(s) |
|---|---|---|
| Active buzzer beeps on the events `vibration.c` is wired to (check call sites — no dedicated menu action) | Audible chirp (bench-tested) | GPIO1, buzzer(+) direct, buzzer(-) to GND. A motor or passive buzzer must go through a transistor driver, never directly on the GPIO |
| If a motor is used instead: flyback diode across it | No voltage spike visible on the GPIO line when the motor stops | — |
| No motor buzz bleeding into I2C/SPI lines (check wiring layout, not just firmware) | Clean display/RFID reads while motor fires | — |

## 4. IR: transmit + receive

| Check | Expected | Pin(s) |
|---|---|---|
| "IR Send Test" transmits a recognizable NEC frame | Verify with a second IR receiver, phone camera (IR LEDs show as faint purple on most phone cameras), or a known target device (e.g. TV power) | TX=GPIO0 (via NPN driver, 1k base resistor) |
| IR receiver picks up an incoming NEC frame | Decoded frame shown/logged | RX=GPIO4 (VS1838B OUT) |
| "IR Learn" captures a remote button press and saves it under a chosen name | Entry appears in "IR Library" afterward, survives a reboot | RX=GPIO4 |
| "IR Library" replays (PRESS) a saved code | Target device reacts the same as to the original remote | TX=GPIO0 |
| "IR Library" delete (LEFT) removes an entry and persists the change | Entry gone from the list after a reboot | — |
| "IR Learn"/"IR Library" behave correctly at capacity (16 entries) | "Library full" shown, existing entries untouched, no crash | — |
| ⚠️ **"IR Direction Find" is not available on this build** — `app_main()` deliberately never calls `ir_direction_init()` (this pin map has no spare RMT RX channels once the regular IR receiver/transmitter are running), and the screen says so explicitly instead of hanging. Do not treat this as a bug to fix; it's a feature kept out of this hardware profile. | Screen shows "Not available on this build" | — |

## 5. RFID/NFC: RC522 (13.56MHz)

| Check | Expected | Pin(s) |
|---|---|---|
| "Read 13.56MHz" detects a MIFARE Classic card in range | UID displayed | SCK=GPIO18, MOSI=GPIO19, MISO=GPIO5, CS=GPIO7, RST=GPIO2 (shared SPI2 bus with the LCD; separate CS) |
| SPI wiring doesn't conflict with the LCD (shared SCK/MOSI, separate CS) | Clean reads on both display and RC522, no bus contention | GPIO18/19 shared; GPIO9 (LCD CS) vs GPIO7 (RC522 CS) must toggle independently |
| "Clone (13.56MHz)" successfully reads a source card's sector data | No `RC522_DUMP_NO_SECTORS` in Errors | same SPI pins |
| "Clone (13.56MHz)" successfully writes to a target (writable) card | Target card's UID/data matches source afterward, verify with "Read 13.56MHz" | same SPI pins |
| Clone failure path records a diag entry with a specific failure reason rather than silently doing nothing | Check "Errors" menu shows `RC522_CLONE_WRITE_FAILED` when write fails (e.g. read-only card) | — |
| 7-byte/10-byte UID cards are reported as unsupported, not misread as a shorter UID | "Errors" shows `RC522_SCAN_UNSUPPORTED_UID`, on-screen message reads "7/10-byte UID: N/A" | — |
| "Save 13.56MHz" saves a scanned UID under a chosen name (UID only, no sector data) | Entry appears in "RFID Library" marked 'H' (high frequency), survives a reboot | same SPI pins |
| If the RC522 fails to attach to the shared SPI bus at boot, the rest of the device (display, buttons, IR) still comes up | No crash, RFID menu items fail cleanly instead | — |

## 6. RFID: RDM6300 (125kHz)

> ℹ️ **UART1 function-clock hang fixed (KNOWN_ISSUES.md Round 28).**
> `rdm6300_init()` no longer hangs the watchdog -- the cause was UART1's
> function clock being left gated by ESP-IDF, not a GPIO conflict, and
> `rdm6300_init()` now enables it before `uart_driver_install()`. On the
> current DEV-KIT-NX build RX is **GPIO15** (GPIO1 is the buzzer). Wire the
> RDM6300 TX line through the level shifter (or a 2.2k/3.3k divider) to GPIO15.

| Check | Expected | Pin(s) |
|---|---|---|
| "Read 125kHz" detects a 125kHz EM4100-family tag in range | Tag ID displayed | RX=GPIO15 (UART1, receive-only module; RDM6300 is 5V, needs a level shifter down to 3.3V) |
| Read is reliable across multiple tag presentations, not just the first one after boot | Repeated reads work without a reboot | GPIO15 |
| "Save 125kHz" saves a scanned tag ID under a chosen name | Entry appears in "RFID Library" marked 'L' (low frequency), survives a reboot | GPIO15 |
| "RFID Library" delete (LEFT) removes an entry (either kind) and persists the change | Entry gone from the list after a reboot | — |
| "Save 125kHz"/"Save 13.56MHz" behave correctly at capacity (16 entries total) | "Library full" shown, existing entries untouched, no crash | — |

## 7. On-chip radio bring-up (single MCU)

There is no second chip and no UART link — Wi-Fi and BLE run directly on
the same ESP32-C6 as the UI (`main/net/c6_link.c`, `main/net/radio_ble.c`).
These rows check that the on-chip radio actually initializes and coexists
with the display and the rest of the UI on one core.

| Check | Expected | Notes |
|---|---|---|
| Wi-Fi + BLE both initialize at boot | No radio-init error in the log | Watch for allocation failures — framebuffer + both radio stacks on one chip |
| Wi-Fi scan returns real nearby networks | Scan screen lists actual SSIDs with RSSI | "WiFi Tara/Bağlan" |
| Wi-Fi Monitor collects APs over a multi-minute run without UI stalls | AP list keeps growing/updating; display stays responsive | Single core runs UI + radio; watch for lag under heavy traffic |
| BLE scan returns real nearby advertisers | BT screen lists devices with address/RSSI | "BT Scan" |
| Wi-Fi scan/connect, local AP, Wi-Fi Monitor, and BT Scan remain mutually exclusive | A conflicting screen explains the need to stop the AP; no hang or corrupted radio state | Check both Wi-Fi and BLE paths in `main/net/` |
| Leaving Wi-Fi Monitor and immediately using WiFi Tara/Bağlan to join a network succeeds reliably | Connect succeeds even right after a monitor session | `s_connect_pending` now ignores a delayed disconnect from monitor teardown; this timing-sensitive path still needs a real-device test. |

## 8. C6 Wi-Fi menu

| Check | Expected | Pin(s)/Bus |
|---|---|---|
| "WiFi Tara/Bağlan" returns a real AP list | SSIDs match what's actually broadcasting nearby | C6 Wi-Fi radio (no dedicated GPIO, on-chip) |
| "WiFi Tara/Bağlan" connects after on-device password entry | "WiFi Durum" shows the station IP | Uses the joystick text-entry grid from section 2 |
| Hacking → "WiFi İzleme (RX)" shows nearby beacon/probe-response traffic while hopping channels | AP list changes as nearby APs change | No Wi-Fi country is configured, so allowed channels follow ESP-IDF defaults; rejected channels are logged and quarantined after three failures. |
| Each listed AP shows a short vendor label derived from its BSSID's OUI (e.g. "TP-Link", "Netgear"), or "?" for an unrecognized OUI | Label matches the AP's actual known hardware vendor where the OUI is in the built-in table | `oui_vendor_lookup()` in `main/net/c6_link.c` — a small built-in table (~25 entries), not a full IEEE OUI database, so "?" for most consumer APs is expected and not a bug |
| WiFi Monitor does not attempt to reconnect STA automatically after stopping (by design) | Confirm this is still true, not an accidental regression | — |
| "WiFi Ağım (AP)" starts a WPA2-protected local network | A phone sees the displayed SSID and can join using the on-screen password; it receives a local IP without Internet | Test with a second device; no web/file service is installed |
| AP status reflects actual associations | Count rises when a phone joins and falls when it leaves; maximum four clients | `esp_wifi_ap_get_sta_list()` reports associated clients, not all nearby devices |
| Leaving the AP screen keeps the AP running; reopening shows the same credentials | Network remains visible and the status screen matches it | LEFT exits without stopping |
| Stopping the AP restores STA mode without automatically reconnecting | Wi-Fi scan works again; previous router link is not silently re-established | Check start/stop several times; also test a failed AP start |
| AP refuses monitor/BLE/STA actions while active | UI reports that AP must be stopped first | AP and those radio workflows are intentionally exclusive |
| The old captive-portal setup remains absent | No web page opens just because the local AP exists | `c6_link_setup()` is still a stub; the new local AP is a separate feature |

## 9. C6 Bluetooth (NimBLE, passive scan)

| Check | Expected | Pin(s)/Bus |
|---|---|---|
| "BT Scan" lists real nearby BLE advertisers | Names/addresses match known nearby devices (phone, earbuds, etc.) | C6 BLE radio (on-chip) |
| Scan is genuinely passive — does not itself become discoverable or connectable | Verify with a second phone/BLE scanner that this device doesn't show up as advertising | `radio_ble.c` sets `params.passive = 1` |
| WiFi Monitor and BT Scan are confirmed mutually exclusive | Attempting to start one while the other runs fails cleanly, not silently | Cross-checked in both directions in `main/net/c6_link.c` and `main/net/radio_ble.c` |

## Known gaps not covered above

- Display/control bring-up has begun, but the rows above remain a checklist,
  not a blanket claim of complete device validation. See
  [KNOWN_ISSUES.md](../../KNOWN_ISSUES.md)'s Round 27 for the audit that found
  this matrix itself was out of date (still describing the retired P4
  pin map) and produced this rewrite.
- Timing-sensitive things (IR NEC frame decode margins, button debounce
  thresholds) can only really be tuned against real hardware; the host
  tests in `tests/` intentionally don't try to fake those.
- Flash/erase-cycle durability of the RC522 clone write path isn't
  something this matrix attempts to cover — treat repeated clone-testing
  on the same target card as consuming its write endurance.
- The PC-side "Errors → Send" log upload from the old two-chip design is
  not part of the standalone build and has no row here; the on-device
  "Errors" history works fully offline instead.
