ErdemWilkinson/makeshift-flipper/main/net/c6_link.c

#include "c6_link.h"

// ---------------------------------------------------------------------------
// STAGE 2 -- direct on-chip radio (C6-standalone).
//
// In the original two-chip design this file was the UI-side client that
// talked to a separate ESP32-C6 over UART, and every call sent a command
// line and parsed reply lines. There is no second chip here: the ESP32-C6
// runs the UI AND the radio, so this file now calls esp_wifi_* directly and
// fills the c6_link_* API the UI uses. Local SoftAP support extends that API.
//
// What maps to what, vs. the old radio-side UART handlers:
//   c6_link_init      <- wifi_commands_init      (netif + esp_wifi STA up)
//   c6_link_scan      <- wifi_commands_scan       (blocking scan, returns list)
//   c6_link_connect   <- wifi_commands_connect_sta(blocking join)
//   c6_link_monitor_* <- wifi_monitor.c           (promiscuous + channel hop)
//   c6_link_bt_scan_* <- bt_scan.c                (BLE scan -- see radio_ble.c)
//
// The old UART-push model (a background task writing "PKT:" lines) is gone:
// the promiscuous callback writes straight into an in-RAM, BSSID-deduplicated
// list, and c6_link_monitor_poll() copies a snapshot of that list -- which is
// exactly the polling shape main.c's monitor screen already expects.
//
// BLE (c6_link_bt_scan_*) lives in radio_ble.c to keep the NimBLE headers out
// of this translation unit; the c6_link_bt_scan_* entry points there fill the
// same API.
// ---------------------------------------------------------------------------

#include <stdlib.h>
#include <stdio.h>
#include <string.h>

#include "esp_event.h"
#include "esp_log.h"
#include "esp_netif.h"
#include "esp_netif_ip_addr.h"
#include "esp_random.h"
#include "esp_wifi.h"

#include "freertos/FreeRTOS.h"
#include "freertos/event_groups.h"
#include "freertos/semphr.h"
#include "freertos/timers.h"

static const char *TAG = "c6_link";

// Defined in radio_ble.c -- brings up the NimBLE stack for BT Scan. Declared
// here (rather than in a header) so c6_link_init() can start it right after
// Wi-Fi without main.c needing a second init call.
void c6_bt_init(void);
bool c6_bt_scan_is_running(void);

// --- Wi-Fi station and local AP bring-up / connect bookkeeping --------------
#define WIFI_CONNECTED_BIT BIT0
#define WIFI_FAIL_BIT      BIT1
#define CONNECT_TIMEOUT_MS 10000

static EventGroupHandle_t s_wifi_event_group;
static esp_netif_t *s_sta_netif;
static esp_netif_t *s_ap_netif;
static bool s_wifi_ready;
static volatile bool s_monitor_running;
static volatile bool s_ap_running;
static char s_ap_ssid[C6_SSID_MAX_LEN + 1];
static char s_ap_password[C6_AP_PASSWORD_LEN + 1];

// Guards against a stale STA-disconnect event clobbering a connect
// attempt's result (KNOWN_ISSUES.md Round 27). c6_link_monitor_start() calls
// the asynchronous esp_wifi_disconnect(); its WIFI_EVENT_STA_DISCONNECTED
// can arrive after a following c6_link_connect() has already cleared the
// bits, which would otherwise set WIFI_FAIL_BIT for a connection attempt
// that has nothing to do with the monitor session. c6_link_connect() sets
// this while (and only while) it has a connect genuinely in flight; the
// event handler only lets a disconnect set WIFI_FAIL_BIT during that
// window, so a disconnect left over from monitor teardown is ignored
// instead of poisoning the next attempt's result.
static volatile bool s_connect_pending;

// Replace control bytes that would corrupt on-screen rendering. Commas no
// longer need escaping because the standalone build has no UART protocol.
static void sanitize_ssid(char *s)
{
    for (; *s != '\0'; s++) {
        unsigned char c = (unsigned char)*s;
        if (c < 0x20 || c == 0x7F) {
            *s = '?';
        }
    }
}

static void wifi_event_handler(void *arg, esp_event_base_t base,
                                int32_t id, void *data)
{
    (void)arg;
    (void)data;
    if (base == WIFI_EVENT && id == WIFI_EVENT_STA_DISCONNECTED) {
        // Only a disconnect belonging to an in-flight c6_link_connect() call
        // should be able to fail it -- see s_connect_pending's comment.
        // A disconnect from monitor teardown, or from a connect attempt that
        // has already timed out/returned, is silently dropped here instead.
        if (s_connect_pending) {
            xEventGroupSetBits(s_wifi_event_group, WIFI_FAIL_BIT);
        }
    } else if (base == IP_EVENT && id == IP_EVENT_STA_GOT_IP) {
        xEventGroupSetBits(s_wifi_event_group, WIFI_CONNECTED_BIT);
    }
}

static bool wifi_init(void)
{
    esp_err_t err = esp_netif_init();
    if (err != ESP_OK) {
        ESP_LOGE(TAG, "esp_netif_init failed: %s", esp_err_to_name(err));
        return false;
    }
    err = esp_event_loop_create_default();
    if (err != ESP_OK) {
        ESP_LOGE(TAG, "event loop init failed: %s", esp_err_to_name(err));
        return false;
    }
    s_sta_netif = esp_netif_create_default_wifi_sta();
    if (s_sta_netif == NULL) {
        ESP_LOGE(TAG, "default Wi-Fi STA netif allocation failed");
        return false;
    }
    // The default AP netif supplies the local DHCP server when AP mode is
    // started later. Its allocation failure must not disable STA Wi-Fi.
    s_ap_netif = esp_netif_create_default_wifi_ap();
    if (s_ap_netif == NULL) {
        ESP_LOGW(TAG, "default Wi-Fi AP netif unavailable; local AP disabled");
    }

    wifi_init_config_t init_cfg = WIFI_INIT_CONFIG_DEFAULT();
    err = esp_wifi_init(&init_cfg);
    if (err != ESP_OK) {
        ESP_LOGE(TAG, "esp_wifi_init failed: %s", esp_err_to_name(err));
        return false;
    }

    s_wifi_event_group = xEventGroupCreate();
    if (s_wifi_event_group == NULL) {
        ESP_LOGE(TAG, "event group alloc failed; Wi-Fi disabled");
        return false;
    }
    err = esp_event_handler_register(WIFI_EVENT, ESP_EVENT_ANY_ID,
                                     &wifi_event_handler, NULL);
    if (err == ESP_OK) {
        err = esp_event_handler_register(IP_EVENT, IP_EVENT_STA_GOT_IP,
                                         &wifi_event_handler, NULL);
    }
    if (err == ESP_OK) {
        // Generated AP passwords and manually entered STA credentials stay
        // in RAM, avoiding a flash write every time the mode changes.
        err = esp_wifi_set_storage(WIFI_STORAGE_RAM);
    }
    if (err == ESP_OK) {
        err = esp_wifi_set_mode(WIFI_MODE_STA);
    }
    if (err == ESP_OK) {
        err = esp_wifi_start();
    }
    if (err != ESP_OK) {
        ESP_LOGE(TAG, "Wi-Fi STA setup failed: %s", esp_err_to_name(err));
        return false;
    }

    ESP_LOGI(TAG, "Wi-Fi STA ready (on-chip radio)");
    return true;
}

void c6_link_init(void)
{
    // NVS is already initialized by app_main(). A radio failure must not
    // prevent the local UI/RFID/IR features from booting.
    s_wifi_ready = wifi_init();

    // BLE initialization is independent of Wi-Fi initialization.
    c6_bt_init();
}

int c6_link_scan(c6_network_t *out_networks, int max_networks)
{
    if (!s_wifi_ready || s_monitor_running || s_ap_running ||
        c6_bt_scan_is_running() ||
        out_networks == NULL || max_networks <= 0) {
        return -1;
    }
    // A monitor session owns the radio's channel; a normal scan can't run
    // alongside it. Callers gate on this too, but guard here as well.
    wifi_scan_config_t scan_cfg = {0};
    if (esp_wifi_scan_start(&scan_cfg, true /* block */) != ESP_OK) {
        return -1;
    }

    uint16_t count = 0;
    if (esp_wifi_scan_get_ap_num(&count) != ESP_OK) {
        return -1;
    }
    if (count == 0) {
        return 0;
    }
    if (count > max_networks) {
        count = (uint16_t)max_networks;
    }

    wifi_ap_record_t *records = malloc(count * sizeof(wifi_ap_record_t));
    if (records == NULL) {
        return -1;
    }
    uint16_t got = count;
    if (esp_wifi_scan_get_ap_records(&got, records) != ESP_OK) {
        free(records);
        return -1;
    }

    int n = 0;
    for (int i = 0; i < got && n < max_networks; i++) {
        records[i].ssid[sizeof(records[i].ssid) - 1] = '\0';
        strncpy(out_networks[n].ssid, (const char *)records[i].ssid,
                C6_SSID_MAX_LEN);
        out_networks[n].ssid[C6_SSID_MAX_LEN] = '\0';
        sanitize_ssid(out_networks[n].ssid);
        out_networks[n].rssi = records[i].rssi;
        n++;
    }
    free(records);
    return n;
}

bool c6_link_connect(const char *ssid, const char *password)
{
    if (!s_wifi_ready || s_monitor_running || s_ap_running ||
        c6_bt_scan_is_running() ||
        s_wifi_event_group == NULL || ssid == NULL || password == NULL) {
        return false;
    }
    size_t password_len = strlen(password);
    if (ssid[0] == '\0' || (password_len > 0 && password_len < 8) ||
        password_len > 63) {
        return false;
    }
    wifi_config_t cfg = {0};
    size_t ssid_len = strlen(ssid);
    if (ssid_len >= sizeof(cfg.sta.ssid)) {
        ssid_len = sizeof(cfg.sta.ssid) - 1;
    }
    memcpy(cfg.sta.ssid, ssid, ssid_len);
    strncpy((char *)cfg.sta.password, password, sizeof(cfg.sta.password) - 1);

    xEventGroupClearBits(s_wifi_event_group, WIFI_CONNECTED_BIT | WIFI_FAIL_BIT);
    // Arm s_connect_pending *before* issuing the connect, so
    // wifi_event_handler() only starts honoring WIFI_EVENT_STA_DISCONNECTED
    // once this attempt is genuinely in flight (see its comment above).
    s_connect_pending = true;
    if (esp_wifi_set_config(WIFI_IF_STA, &cfg) != ESP_OK) {
        s_connect_pending = false;
        return false;
    }
    if (esp_wifi_connect() != ESP_OK) {
        s_connect_pending = false;
        return false;
    }
    EventBits_t bits = xEventGroupWaitBits(s_wifi_event_group,
                                           WIFI_CONNECTED_BIT | WIFI_FAIL_BIT,
                                           pdFALSE, pdFALSE,
                                           pdMS_TO_TICKS(CONNECT_TIMEOUT_MS));
    // Stop honoring disconnect events for this attempt once we've returned
    // an answer for it -- any later disconnect belongs to whatever the
    // caller does next (another connect, or a monitor session), not to this
    // finished attempt.
    s_connect_pending = false;
    return (bits & WIFI_CONNECTED_BIT) != 0;
}

bool c6_link_get_wifi_status(c6_wifi_status_t *out_status)
{
    if (out_status == NULL) {
        return false;
    }
    memset(out_status, 0, sizeof(*out_status));
    if (!s_wifi_ready || s_monitor_running || s_ap_running ||
        s_sta_netif == NULL) {
        return false;
    }
    wifi_ap_record_t ap;
    esp_netif_ip_info_t ip_info;
    if (esp_wifi_sta_get_ap_info(&ap) != ESP_OK ||
        esp_netif_get_ip_info(s_sta_netif, &ip_info) != ESP_OK ||
        ip_info.ip.addr == 0) {
        return false;
    }
    memcpy(out_status->ssid, ap.ssid, C6_SSID_MAX_LEN);
    out_status->ssid[C6_SSID_MAX_LEN] = '\0';
    sanitize_ssid(out_status->ssid);
    out_status->rssi = ap.rssi;
    out_status->channel = ap.primary;
    snprintf(out_status->ip, sizeof(out_status->ip), IPSTR, IP2STR(&ip_info.ip));
    snprintf(out_status->gateway, sizeof(out_status->gateway), IPSTR, IP2STR(&ip_info.gw));
    return true;
}

// Re-establish only the Wi-Fi station interface. Deliberately do not call
// esp_wifi_connect(): returning from a local AP must not silently reconnect
// to a previous network. Also used to recover from a failed AP start.
static bool restore_sta_mode(void)
{
    esp_err_t err = esp_wifi_stop();
    if (err != ESP_OK && err != ESP_ERR_WIFI_NOT_STARTED) {
        ESP_LOGE(TAG, "Wi-Fi stop during STA restore failed: %s", esp_err_to_name(err));
        s_wifi_ready = false;
        return false;
    }
    err = esp_wifi_set_mode(WIFI_MODE_STA);
    if (err == ESP_OK) {
        err = esp_wifi_start();
    }
    s_wifi_ready = (err == ESP_OK);
    if (!s_wifi_ready) {
        ESP_LOGE(TAG, "Wi-Fi STA restore failed: %s", esp_err_to_name(err));
    }
    return s_wifi_ready;
}

bool c6_link_ap_start(void)
{
    if (s_ap_running) {
        return true;
    }
    if (!s_wifi_ready || s_ap_netif == NULL || s_monitor_running ||
        c6_bt_scan_is_running()) {
        return false;
    }

    uint8_t mac[6];
    if (esp_wifi_get_mac(WIFI_IF_STA, mac) != ESP_OK) {
        return false;
    }
    char ssid[C6_SSID_MAX_LEN + 1];
    snprintf(ssid, sizeof(ssid), "Makeshift-%02X%02X%02X",
             mac[3], mac[4], mac[5]);
    uint8_t secret[6];
    esp_fill_random(secret, sizeof(secret));
    char password[C6_AP_PASSWORD_LEN + 1];
    snprintf(password, sizeof(password), "%02X%02X%02X%02X%02X%02X",
             secret[0], secret[1], secret[2], secret[3], secret[4], secret[5]);

    wifi_config_t cfg = {0};
    memcpy(cfg.ap.ssid, ssid, strlen(ssid));
    cfg.ap.ssid_len = (uint8_t)strlen(ssid);
    memcpy(cfg.ap.password, password, C6_AP_PASSWORD_LEN);
    cfg.ap.channel = 1;
    cfg.ap.max_connection = 4;
    cfg.ap.authmode = WIFI_AUTH_WPA2_PSK;

    s_connect_pending = false;
    // Switching to exclusive AP mode intentionally drops the STA link.
    esp_wifi_disconnect();
    esp_err_t err = esp_wifi_stop();
    if (err != ESP_OK) {
        ESP_LOGE(TAG, "Wi-Fi stop before AP failed: %s", esp_err_to_name(err));
        return false;
    }
    err = esp_wifi_set_mode(WIFI_MODE_AP);
    if (err == ESP_OK) {
        err = esp_wifi_set_config(WIFI_IF_AP, &cfg);
    }
    if (err == ESP_OK) {
        err = esp_wifi_start();
    }
    if (err != ESP_OK) {
        ESP_LOGE(TAG, "local AP start failed: %s", esp_err_to_name(err));
        restore_sta_mode();
        return false;
    }
    snprintf(s_ap_ssid, sizeof(s_ap_ssid), "%s", ssid);
    memcpy(s_ap_password, password, sizeof(password));
    s_ap_running = true;
    ESP_LOGI(TAG, "local AP started: SSID=%s (password shown only on LCD)", s_ap_ssid);
    return true;
}

bool c6_link_ap_stop(void)
{
    if (!s_ap_running) {
        return true;
    }
    esp_err_t err = esp_wifi_stop();
    if (err != ESP_OK) {
        ESP_LOGE(TAG, "local AP stop failed: %s", esp_err_to_name(err));
        return false;
    }
    s_ap_running = false;
    memset(s_ap_password, 0, sizeof(s_ap_password));
    s_ap_ssid[0] = '\0';
    ESP_LOGI(TAG, "local AP stopped");
    return restore_sta_mode();
}

bool c6_link_ap_is_running(void)
{
    return s_ap_running;
}

// --- Sifresiz (open) AP: captive portal icin. Belirtilen SSID ile acar. ---
// Normal c6_link_ap_start ile ayni radyo/netif'i kullanir; ayni anda ikisi
// birden calismaz. Captive portal modulu (captive_portal.c) cagirir.
bool c6_link_ap_open_start(const char *ssid)
{
    if (s_ap_running) {
        return false; // once mevcut AP'yi kapat
    }
    if (!s_wifi_ready || s_ap_netif == NULL || s_monitor_running ||
        c6_bt_scan_is_running()) {
        return false;
    }
    if (ssid == NULL || ssid[0] == '\0') {
        return false;
    }

    wifi_config_t cfg = {0};
    size_t sl = strlen(ssid);
    if (sl > C6_SSID_MAX_LEN) sl = C6_SSID_MAX_LEN;
    memcpy(cfg.ap.ssid, ssid, sl);
    cfg.ap.ssid_len = (uint8_t)sl;
    cfg.ap.channel = 1;
    cfg.ap.max_connection = 4;
    cfg.ap.authmode = WIFI_AUTH_OPEN;   // sifresiz

    s_connect_pending = false;
    esp_wifi_disconnect();
    esp_err_t err = esp_wifi_stop();
    if (err != ESP_OK) {
        ESP_LOGE(TAG, "Wi-Fi stop before open AP failed: %s", esp_err_to_name(err));
        return false;
    }
    err = esp_wifi_set_mode(WIFI_MODE_AP);
    if (err == ESP_OK) err = esp_wifi_set_config(WIFI_IF_AP, &cfg);
    if (err == ESP_OK) err = esp_wifi_start();
    if (err != ESP_OK) {
        ESP_LOGE(TAG, "open AP start failed: %s", esp_err_to_name(err));
        restore_sta_mode();
        return false;
    }
    snprintf(s_ap_ssid, sizeof(s_ap_ssid), "%.*s", (int)sl, ssid);
    s_ap_password[0] = '\0';
    s_ap_running = true;
    ESP_LOGI(TAG, "open AP started: SSID=%s", s_ap_ssid);
    return true;
}

void c6_link_ap_open_stop(void)
{
    if (!s_ap_running) return;
    esp_wifi_stop();
    s_ap_running = false;
    s_ap_ssid[0] = '\0';
    restore_sta_mode();
    ESP_LOGI(TAG, "open AP stopped");
}

bool c6_link_ap_get_status(c6_ap_status_t *out_status)
{
    if (out_status == NULL) {
        return false;
    }
    memset(out_status, 0, sizeof(*out_status));
    if (!s_ap_running || s_ap_netif == NULL) {
        return false;
    }
    memcpy(out_status->ssid, s_ap_ssid, sizeof(s_ap_ssid));
    memcpy(out_status->password, s_ap_password, sizeof(s_ap_password));
    out_status->client_count = -1;
    esp_netif_ip_info_t ip_info;
    if (esp_netif_get_ip_info(s_ap_netif, &ip_info) == ESP_OK &&
        ip_info.ip.addr != 0) {
        snprintf(out_status->ip, sizeof(out_status->ip), IPSTR,
                 IP2STR(&ip_info.ip));
    } else {
        strncpy(out_status->ip, "?", sizeof(out_status->ip) - 1);
    }
    wifi_sta_list_t clients = {0};
    if (esp_wifi_ap_get_sta_list(&clients) == ESP_OK) {
        out_status->client_count = clients.num;
    }
    return true;
}

bool c6_link_send(const char *ip, uint16_t port, const char *data)
{
    // TCP send is not part of any current UI action on the standalone build
    // (it existed for a PC-side helper flow). Left unimplemented for now --
    // returns false so any future caller sees a clean "failed" rather than a
    // silent success. Port the lwip socket code from the old
    // wifi_commands_send() here if a UI feature ever needs it.
    (void)ip;
    (void)port;
    (void)data;
    return false;
}

bool c6_link_setup(const char *pin)
{
    // The old web-based setup flow (HTTP server + captive portal) remains
    // unavailable. c6_link_ap_start() is a separate local network without
    // a web interface; manual scan/connect remains the STA join path.
    (void)pin;
    return false;
}

bool c6_link_send_error_log(const diag_entry_t *entries, int count)
{
    // Depended on the PC-side HTTP log collector over the old link. Not part
    // of standalone bring-up; the on-device Errors history works fully
    // offline without it.
    (void)entries;
    (void)count;
    return false;
}

// --- Wi-Fi Monitor (promiscuous) -------------------------------------------
#define MONITOR_CHANNEL_COUNT 13
#define MONITOR_CHANNEL_HOP_MS 400
#define FRAME_SUBTYPE_BEACON         0x80
#define FRAME_SUBTYPE_PROBE_RESPONSE 0x50
#define FRAME_SUBTYPE_PROBE_REQUEST  0x40
#define FRAME_SUBTYPE_MASK           0xF0
// The two Type bits of the Frame Control field (bits 2-3 of the first octet):
// 00 = management, 01 = control, 10 = data.
#define FRAME_TYPE_MASK              0x0C
#define FRAME_TYPE_MGMT              0x00
#define FRAME_TYPE_CTRL             0x04
#define FRAME_TYPE_DATA             0x08

// Small built-in table of IEEE-registered OUI prefixes (first 3 BSSID
// bytes) for well-known Wi-Fi chipset/AP vendors, used only to label the
// live scan list ("Live TUI Scan" vendor column, per the feature request
// this was added for). Not exhaustive -- a handful of common router/AP
// vendors, not a full IEEE OUI database (that's tens of thousands of
// entries and would not fit in flash usefully for this screen). Falls
// back to "?" for anything not listed; this is a cosmetic label, not a
// device fingerprinting feature, and identifies hardware manufacturer
// only, never a person.
typedef struct {
    uint8_t oui[3];
    const char *name;
} oui_entry_t;

static const oui_entry_t s_oui_table[] = {
    {{0xB8, 0x27, 0xEB}, "RPi"},      // Raspberry Pi Foundation
    {{0xDC, 0xA6, 0x32}, "RPi"},
    {{0x00, 0x1A, 0x11}, "Google"},
    {{0xF4, 0xF5, 0xD8}, "Google"},
    {{0x00, 0x1B, 0x63}, "Apple"},
    {{0x3C, 0x15, 0xC2}, "Apple"},
    {{0xAC, 0xDE, 0x48}, "Apple"},
    {{0x00, 0x17, 0x88}, "Philips"},
    {{0x00, 0x14, 0xBF}, "Cisco"},
    {{0x00, 0x1D, 0x7E}, "Cisco"},
    {{0x00, 0x0F, 0x66}, "Cisco"},
    {{0x00, 0x1F, 0x3B}, "TP-Link"},
    {{0x14, 0xCC, 0x20}, "TP-Link"},
    {{0x50, 0xC7, 0xBF}, "TP-Link"},
    {{0xC4, 0x6E, 0x1F}, "TP-Link"},
    {{0x00, 0x1E, 0x2A}, "Netgear"},
    {{0x20, 0x4E, 0x7F}, "Netgear"},
    {{0xA0, 0x40, 0xA0}, "Netgear"},
    {{0x00, 0x24, 0x01}, "ASUS"},
    {{0x1C, 0x87, 0x2C}, "ASUS"},
    {{0x2C, 0x56, 0xDC}, "ASUS"},
    {{0x00, 0x1F, 0x33}, "Huawei"},
    {{0x00, 0x25, 0x9E}, "Huawei"},
    {{0x38, 0xF7, 0x3D}, "Xiaomi"},
    {{0x64, 0xB4, 0x73}, "Xiaomi"},
    {{0x00, 0x0C, 0x29}, "VMware"},
    {{0x00, 0x50, 0x56}, "VMware"},
    {{0x08, 0x00, 0x27}, "VBox"},
};
#define OUI_TABLE_COUNT (sizeof(s_oui_table) / sizeof(s_oui_table[0]))

static void oui_vendor_lookup(const uint8_t bssid[6], char *out, size_t out_cap)
{
    for (size_t i = 0; i < OUI_TABLE_COUNT; i++) {
        if (memcmp(bssid, s_oui_table[i].oui, 3) == 0) {
            strncpy(out, s_oui_table[i].name, out_cap - 1);
            out[out_cap - 1] = '\0';
            return;
        }
    }
    strncpy(out, "?", out_cap - 1);
    out[out_cap - 1] = '\0';
}

// Quarantines a channel the radio has repeatedly refused to hop to (e.g.
// disallowed by the current regulatory/default configuration -- see
// hop_timer_cb()'s existing warning log for a single failure). After
// QUARANTINE_FAIL_THRESHOLD consecutive rejections that channel is skipped
// for the rest of this monitor session, so the hop timer stops wasting
// cycles retrying a channel the radio will never actually reach, and spends
// more time on channels that do work. Cleared at the start of every new
// c6_link_monitor_start() session (a different session might succeed on a
// previously-quarantined channel, e.g. after a country/regdomain change).
#define QUARANTINE_FAIL_THRESHOLD 3
static uint8_t s_channel_fail_streak[MONITOR_CHANNEL_COUNT + 1]; // index by channel number, [0] unused
static bool s_channel_quarantined[MONITOR_CHANNEL_COUNT + 1];

static int s_monitor_channel = 1;
static volatile uint16_t s_hop_mask; // 0 = hop all channels
static TimerHandle_t s_hop_timer;
static SemaphoreHandle_t s_monitor_lock; // guards the AP list below

// In-RAM deduplicated AP list. Replaces the old UART PKT-push task: the
// promiscuous callback updates this in place (by BSSID), and
// c6_link_monitor_poll() snapshots it. Capped at C6_MONITOR_MAX_APS; a new
// BSSID past the cap is dropped, a repeat sighting updates rssi/channel.
static c6_monitor_ap_t s_monitor_aps[C6_MONITOR_MAX_APS];
static int s_monitor_ap_count;

// Cumulative frame-type tally for the current monitor session. Written only in
// monitor_rx_cb() (Wi-Fi task context, not an ISR) and snapshotted under
// s_monitor_lock by c6_link_monitor_frame_stats(). uint32_t counters are
// updated as a single word, but the lock keeps a poll from reading a half-set
// of counters mid-update. Zeroed at the start of every monitor session.
static c6_frame_stats_t s_frame_stats;

// Deduplicated probe-request SSID list (networks nearby clients are looking
// for). Updated in monitor_rx_cb under s_monitor_lock, snapshotted by
// c6_link_monitor_probe_poll. Reset each monitor session.
static c6_probe_ssid_t s_probe_ssids[C6_PROBE_MAX];
static int s_probe_count;

// Add/count one probe SSID. Caller holds s_monitor_lock.
static void probe_upsert(const char *ssid)
{
    if (ssid[0] == '\0') {
        return; // broadcast/wildcard probe -- no specific network named
    }
    for (int i = 0; i < s_probe_count; i++) {
        if (strncmp(s_probe_ssids[i].ssid, ssid, C6_MONITOR_SSID_MAX_LEN) == 0) {
            if (s_probe_ssids[i].count < 0xFFFF) {
                s_probe_ssids[i].count++;
            }
            return;
        }
    }
    if (s_probe_count < C6_PROBE_MAX) {
        strncpy(s_probe_ssids[s_probe_count].ssid, ssid, C6_MONITOR_SSID_MAX_LEN);
        s_probe_ssids[s_probe_count].ssid[C6_MONITOR_SSID_MAX_LEN] = '\0';
        s_probe_ssids[s_probe_count].count = 1;
        s_probe_count++;
    }
}

// Per-device probe list, keyed by source MAC, for the combined radar. Updated
// in monitor_rx_cb under s_monitor_lock, snapshotted by
// c6_link_monitor_probe_dev_poll. Reset each monitor session.
static c6_probe_dev_t s_probe_devs[C6_PROBE_DEV_MAX];
static int s_probe_dev_count;

// Add/update one probing device by MAC + RSSI (+ the SSID it named, if any).
// Caller holds s_monitor_lock.
static void probe_dev_upsert(const uint8_t mac[6], int8_t rssi, const char *ssid)
{
    for (int i = 0; i < s_probe_dev_count; i++) {
        if (memcmp(s_probe_devs[i].mac, mac, 6) == 0) {
            s_probe_devs[i].rssi = rssi;
            s_probe_devs[i].seen_seq++;
            if (s_probe_devs[i].count < 0xFFFF) {
                s_probe_devs[i].count++;
            }
            if (ssid[0] != '\0') {
                strncpy(s_probe_devs[i].last_ssid, ssid, C6_MONITOR_SSID_MAX_LEN);
                s_probe_devs[i].last_ssid[C6_MONITOR_SSID_MAX_LEN] = '\0';
            }
            return;
        }
    }
    if (s_probe_dev_count < C6_PROBE_DEV_MAX) {
        c6_probe_dev_t *d = &s_probe_devs[s_probe_dev_count];
        memcpy(d->mac, mac, 6);
        d->rssi = rssi;
        d->count = 1;
        d->seen_seq = 1;
        d->last_ssid[0] = '\0';
        if (ssid[0] != '\0') {
            strncpy(d->last_ssid, ssid, C6_MONITOR_SSID_MAX_LEN);
            d->last_ssid[C6_MONITOR_SSID_MAX_LEN] = '\0';
        }
        s_probe_dev_count++;
    }
}

static const char *parse_security_mode(const uint8_t *payload, int len)
{
    if (len < 36) {
        return "UNKNOWN";
    }
    uint16_t capability = (uint16_t)payload[34] |
                          ((uint16_t)payload[35] << 8);
    bool privacy = (capability & 0x0010) != 0;
    if (!privacy) {
        return "OPEN";
    }

    bool rsn = false;
    bool wpa = false;
    bool wpa3 = false;
    int i = 36; // past fixed beacon fields
    while (i + 2 <= len) {
        uint8_t id = payload[i];
        uint8_t elen = payload[i + 1];
        if (i + 2 + elen > len) {
            break;
        }
        if (id == 0x30) {
            rsn = true; // RSN element => WPA2/WPA3
            const uint8_t *data = &payload[i + 2];
            if (elen >= 10) {
                uint16_t pairwise_count = (uint16_t)data[6] |
                                          ((uint16_t)data[7] << 8);
                int akm_count_offset = 8 + 4 * pairwise_count;
                if (akm_count_offset + 2 <= elen) {
                    uint16_t akm_count = (uint16_t)data[akm_count_offset] |
                                         ((uint16_t)data[akm_count_offset + 1] << 8);
                    int akm = akm_count_offset + 2;
                    for (int k = 0; k < akm_count && akm + 4 <= elen; k++, akm += 4) {
                        if (data[akm] == 0x00 && data[akm + 1] == 0x0F &&
                            data[akm + 2] == 0xAC &&
                            (data[akm + 3] == 8 || data[akm + 3] == 24)) {
                            wpa3 = true; // SAE / SAE-EXT
                        }
                    }
                }
            }
        } else if (id == 0xDD && elen >= 4 &&
                   payload[i + 2] == 0x00 && payload[i + 3] == 0x50 &&
                   payload[i + 4] == 0xF2 && payload[i + 5] == 0x01) {
            wpa = true; // Microsoft WPA IE
        }
        i += 2 + elen;
    }
    if (wpa3) {
        return "WPA3";
    }
    if (rsn) {
        return "WPA2";
    }
    if (wpa) {
        return "WPA";
    }
    return "WEP";
}

// Insert-or-update one AP in the deduped list. Caller holds s_monitor_lock.
static void monitor_upsert(const c6_monitor_ap_t *ap)
{
    for (int i = 0; i < s_monitor_ap_count; i++) {
        if (memcmp(s_monitor_aps[i].bssid, ap->bssid, 6) == 0) {
            s_monitor_aps[i].rssi = ap->rssi;
            s_monitor_aps[i].channel = ap->channel;
            s_monitor_aps[i].seen_seq++;
            if (ap->ssid[0] != '\0') {
                memcpy(s_monitor_aps[i].ssid, ap->ssid, sizeof(ap->ssid));
            }
            if (ap->sec[0] != '\0') {
                memcpy(s_monitor_aps[i].sec, ap->sec, sizeof(ap->sec));
            }
            return;
        }
    }
    if (s_monitor_ap_count < C6_MONITOR_MAX_APS) {
        s_monitor_aps[s_monitor_ap_count] = *ap;
        s_monitor_aps[s_monitor_ap_count].seen_seq = 1;
        s_monitor_ap_count++;
    }
}

static void monitor_rx_cb(void *buf, wifi_promiscuous_pkt_type_t type)
{
    if (!s_monitor_running) {
        return;
    }
    const wifi_promiscuous_pkt_t *pkt = (const wifi_promiscuous_pkt_t *)buf;
    const uint8_t *payload = pkt->payload;
    int len = pkt->rx_ctrl.sig_len;
    if (len < 1) {
        return;
    }

    // Frame-type tally. Every frame the promiscuous filter lets through is
    // classified from the Frame Control octet (payload[0]); this needs only
    // that one byte, so it runs for short control frames too. Guarded by the
    // same lock the AP list uses so a concurrent frame_stats() poll never
    // reads a partially-updated set of counters.
    uint8_t fc_type = payload[0] & FRAME_TYPE_MASK;
    uint8_t subtype = payload[0] & FRAME_SUBTYPE_MASK;
    if (s_monitor_lock != NULL &&
        xSemaphoreTake(s_monitor_lock, 0) == pdTRUE) {
        s_frame_stats.total++;
        if (fc_type == FRAME_TYPE_MGMT) {
            if (subtype == FRAME_SUBTYPE_BEACON) {
                s_frame_stats.mgmt_beacon++;
            } else if (subtype == FRAME_SUBTYPE_PROBE_REQUEST) {
                s_frame_stats.mgmt_probe_req++;
            } else if (subtype == FRAME_SUBTYPE_PROBE_RESPONSE) {
                s_frame_stats.mgmt_probe_resp++;
            } else {
                s_frame_stats.mgmt_other++;
            }
        } else if (fc_type == FRAME_TYPE_DATA) {
            s_frame_stats.data++;
        } else if (fc_type == FRAME_TYPE_CTRL) {
            s_frame_stats.ctrl++;
        }
        xSemaphoreGive(s_monitor_lock);
    }

    // Probe requests: a client naming a network it is looking for. The SSID is
    // the first information element right after the 24-byte MAC header (no fixed
    // beacon fields on a probe request). Collect the named SSID passively.
    if (type == WIFI_PKT_MGMT && subtype == FRAME_SUBTYPE_PROBE_REQUEST &&
        len >= 24 + 2) {
        int ie = 24;
        uint8_t id = payload[ie];
        uint8_t ie_len = payload[ie + 1];
        if (id == 0x00 && ie_len <= C6_MONITOR_SSID_MAX_LEN &&
            ie + 2 + ie_len <= len) {
            char ssid[C6_MONITOR_SSID_MAX_LEN + 1];
            memcpy(ssid, &payload[ie + 2], ie_len);
            ssid[ie_len] = '\0';
            sanitize_ssid(ssid);
            // Source MAC (SA) sits at bytes 10..15 of the 802.11 MAC header on
            // a probe request; RSSI comes from the receive control block. Both
            // are already in the frame the radio received -- reading them adds
            // no transmission. Feeds the per-device probe list for the radar.
            uint8_t src_mac[6];
            memcpy(src_mac, &payload[10], 6);
            int8_t probe_rssi = pkt->rx_ctrl.rssi;
            if (s_monitor_lock != NULL &&
                xSemaphoreTake(s_monitor_lock, 0) == pdTRUE) {
                probe_upsert(ssid);
                probe_dev_upsert(src_mac, probe_rssi, ssid);
                xSemaphoreGive(s_monitor_lock);
            }
        }
        return;
    }

    // Beyond the tally, only beacons/probe-responses feed the deduped AP list,
    // and only those carry the fixed fields + IEs the parse below reads.
    if (type != WIFI_PKT_MGMT || len < 36) {
        return;
    }
    if (subtype != FRAME_SUBTYPE_BEACON && subtype != FRAME_SUBTYPE_PROBE_RESPONSE) {
        return;
    }

    c6_monitor_ap_t ap = {0};
    memcpy(ap.bssid, &payload[10], 6); // addr2 (BSSID)
    ap.rssi = pkt->rx_ctrl.rssi;
    ap.channel = pkt->rx_ctrl.channel;
    oui_vendor_lookup(ap.bssid, ap.vendor, sizeof(ap.vendor));

    for (int ie = 36; ie + 2 <= len;) {
        uint8_t id = payload[ie];
        uint8_t ie_len = payload[ie + 1];
        if (ie + 2 + ie_len > len) {
            break;
        }
        if (id == 0x00 && ie_len <= C6_MONITOR_SSID_MAX_LEN) {
            memcpy(ap.ssid, &payload[ie + 2], ie_len);
            ap.ssid[ie_len] = '\0';
            sanitize_ssid(ap.ssid);
            break;
        }
        ie += 2 + ie_len;
    }
    const char *sec = parse_security_mode(payload, len);
    strncpy(ap.sec, sec, sizeof(ap.sec) - 1);

    // The callback runs in Wi-Fi task context; take the lock briefly. Using
    // a mutex here is safe because this is not an ISR.
    if (s_monitor_lock != NULL &&
        xSemaphoreTake(s_monitor_lock, 0) == pdTRUE) {
        monitor_upsert(&ap);
        xSemaphoreGive(s_monitor_lock);
    }
}

static void hop_timer_cb(TimerHandle_t t)
{
    (void)t;
    // Walk forward from the current channel to the next one that isn't
    // quarantined. Bounded by MONITOR_CHANNEL_COUNT so this can't spin
    // forever even if every channel ends up quarantined (falls through to
    // whatever candidate the loop lands on last -- see below).
    int candidate = s_monitor_channel;
    int next_channel = candidate;
    uint16_t mask = s_hop_mask;
    for (int tries = 0; tries < MONITOR_CHANNEL_COUNT; tries++) {
        candidate = (candidate % MONITOR_CHANNEL_COUNT) + 1;
        bool wanted = (mask == 0) || (mask & (1u << candidate));
        if (wanted && !s_channel_quarantined[candidate]) {
            next_channel = candidate;
            break;
        }
        next_channel = candidate; // last candidate wins if all are quarantined
    }

    // No Wi-Fi country is configured on this build, so the regulatory
    // channel set esp_wifi actually allows is whatever ESP-IDF's default
    // is -- not necessarily all of 1-13 (KNOWN_ISSUES.md Round 27). A
    // rejected hop used to be silently discarded: s_monitor_channel would
    // still advance, so the UI could show a channel the radio never
    // actually switched to, while the monitor quietly stopped seeing
    // anything on it. Only advance the tracked channel -- and log -- when
    // the hop actually succeeds, so a persistently-refused channel is at
    // least visible in the log instead of invisible in the UI.
    esp_err_t err = esp_wifi_set_channel(next_channel, WIFI_SECOND_CHAN_NONE);
    if (err == ESP_OK) {
        s_monitor_channel = next_channel;
        s_channel_fail_streak[next_channel] = 0;
    } else {
        ESP_LOGW(TAG, "channel hop to %d rejected: %s", next_channel,
                 esp_err_to_name(err));
        // Quarantine a channel that's failed QUARANTINE_FAIL_THRESHOLD times
        // in a row -- see s_channel_quarantined's comment. Uses saturating
        // increment so this can't wrap a uint8_t back to 0 if a channel
        // somehow gets hit far more than the threshold before being skipped.
        if (s_channel_fail_streak[next_channel] < 0xFF) {
            s_channel_fail_streak[next_channel]++;
        }
        if (s_channel_fail_streak[next_channel] >= QUARANTINE_FAIL_THRESHOLD &&
            !s_channel_quarantined[next_channel]) {
            s_channel_quarantined[next_channel] = true;
            ESP_LOGW(TAG, "channel %d quarantined after %d consecutive failures",
                     next_channel, QUARANTINE_FAIL_THRESHOLD);
        }
    }
}

bool c6_link_monitor_start(void)
{
    if (!s_wifi_ready || s_ap_running || c6_bt_scan_is_running()) {
        return false;
    }
    if (s_monitor_running) {
        return true;
    }
    if (s_monitor_lock == NULL) {
        s_monitor_lock = xSemaphoreCreateMutex();
    }
    if (s_hop_timer == NULL) {
        s_hop_timer = xTimerCreate("c6_mon_hop",
                                   pdMS_TO_TICKS(MONITOR_CHANNEL_HOP_MS),
                                   pdTRUE, NULL, hop_timer_cb);
    }
    if (s_monitor_lock == NULL || s_hop_timer == NULL) {
        return false;
    }

    // Clear last session's list, frame tally, and probe SSIDs.
    if (xSemaphoreTake(s_monitor_lock, portMAX_DELAY) == pdTRUE) {
        s_monitor_ap_count = 0;
        memset(&s_frame_stats, 0, sizeof(s_frame_stats));
        s_probe_count = 0;
        s_probe_dev_count = 0;
        xSemaphoreGive(s_monitor_lock);
    }

    // Clear last session's channel quarantine state -- a fresh session
    // might succeed on a channel the previous one gave up on (e.g. after a
    // country/regdomain change), so don't carry the penalty forward.
    memset(s_channel_fail_streak, 0, sizeof(s_channel_fail_streak));
    memset(s_channel_quarantined, 0, sizeof(s_channel_quarantined));
    s_hop_mask = 0;

    // Promiscuous mode and a connected STA fight over the channel; drop any
    // active connection first (no auto-reconnect, same as the old design).
    esp_wifi_disconnect();

    // Accept management, data and control frames. The AP list still only acts
    // on beacons/probe-responses (see monitor_rx_cb), but the frame-type tally
    // and, indirectly, a fuller picture of channel activity need data/ctrl
    // frames to pass the hardware filter too. Still strictly receive-only.
    wifi_promiscuous_filter_t filter = {
        .filter_mask = WIFI_PROMIS_FILTER_MASK_MGMT |
                       WIFI_PROMIS_FILTER_MASK_DATA |
                       WIFI_PROMIS_FILTER_MASK_CTRL,
    };
    esp_err_t err = esp_wifi_set_promiscuous_filter(&filter);
    if (err != ESP_OK) {
        return false;
    }
    err = esp_wifi_set_promiscuous_rx_cb(monitor_rx_cb);
    if (err != ESP_OK) {
        return false;
    }
    err = esp_wifi_set_promiscuous(true);
    if (err != ESP_OK) {
        esp_wifi_set_promiscuous_rx_cb(NULL);
        return false;
    }
    s_monitor_channel = 1;
    err = esp_wifi_set_channel(s_monitor_channel, WIFI_SECOND_CHAN_NONE);
    if (err != ESP_OK) {
        esp_wifi_set_promiscuous(false);
        esp_wifi_set_promiscuous_rx_cb(NULL);
        return false;
    }
    s_monitor_running = true;
    if (xTimerStart(s_hop_timer, 0) != pdPASS) {
        s_monitor_running = false;
        esp_wifi_set_promiscuous(false);
        esp_wifi_set_promiscuous_rx_cb(NULL);
        return false;
    }
    ESP_LOGI(TAG, "Wi-Fi monitor started");
    return true;
}

bool c6_link_monitor_stop(void)
{
    if (!s_monitor_running) {
        return true;
    }
    s_monitor_running = false;
    if (s_hop_timer != NULL) {
        xTimerStop(s_hop_timer, portMAX_DELAY);
    }
    esp_err_t promiscuous_err = esp_wifi_set_promiscuous(false);
    esp_err_t callback_err = esp_wifi_set_promiscuous_rx_cb(NULL);
    ESP_LOGI(TAG, "Wi-Fi monitor stopped");
    return promiscuous_err == ESP_OK && callback_err == ESP_OK;
}

bool c6_wifi_monitor_is_running(void)
{
    return s_monitor_running;
}

int c6_link_monitor_poll(c6_monitor_ap_t *out_aps, int max_aps)
{
    if (out_aps == NULL || max_aps <= 0 || s_monitor_lock == NULL) {
        return 0;
    }
    int n = 0;
    if (xSemaphoreTake(s_monitor_lock, pdMS_TO_TICKS(20)) == pdTRUE) {
        n = s_monitor_ap_count < max_aps ? s_monitor_ap_count : max_aps;
        memcpy(out_aps, s_monitor_aps, n * sizeof(c6_monitor_ap_t));
        xSemaphoreGive(s_monitor_lock);
    }
    return n;
}

void c6_link_monitor_set_hop_mask(uint16_t mask)
{
    s_hop_mask = mask & 0x3FFE; // channels 1..13 only
}

bool c6_link_monitor_channel_stats(c6_channel_stats_t *out_stats)
{
    if (out_stats == NULL || !s_monitor_running || s_monitor_lock == NULL) {
        return false;
    }
    memset(out_stats, 0, sizeof(*out_stats));
    if (xSemaphoreTake(s_monitor_lock, pdMS_TO_TICKS(20)) != pdTRUE) {
        return false;
    }
    for (int i = 0; i < s_monitor_ap_count; i++) {
        uint8_t ch = s_monitor_aps[i].channel;
        if (ch < 1 || ch > C6_CHANNEL_COUNT) {
            continue; // out-of-range / unknown channel -- skip, don't clobber [0]
        }
        if (out_stats->ap_count[ch] < 0xFF) {
            out_stats->ap_count[ch]++;
        }
        int8_t rssi = s_monitor_aps[i].rssi;
        // best_rssi starts at 0 (sentinel for "none seen"); real RSSI is
        // negative, so the first sighting always replaces the sentinel and
        // later ones keep the strongest (closest to 0).
        if (out_stats->best_rssi[ch] == 0 || rssi > out_stats->best_rssi[ch]) {
            out_stats->best_rssi[ch] = rssi;
        }
    }
    xSemaphoreGive(s_monitor_lock);
    return true;
}

int c6_link_monitor_current_channel(void)
{
    return s_monitor_running ? s_monitor_channel : 0;
}

bool c6_link_monitor_frame_stats(c6_frame_stats_t *out_stats)
{
    if (out_stats == NULL || !s_monitor_running || s_monitor_lock == NULL) {
        return false;
    }
    if (xSemaphoreTake(s_monitor_lock, pdMS_TO_TICKS(20)) != pdTRUE) {
        return false;
    }
    *out_stats = s_frame_stats;
    xSemaphoreGive(s_monitor_lock);
    return true;
}

int c6_link_monitor_probe_poll(c6_probe_ssid_t *out, int max_entries)
{
    if (out == NULL || max_entries <= 0 || !s_monitor_running ||
        s_monitor_lock == NULL) {
        return 0;
    }
    int n = 0;
    if (xSemaphoreTake(s_monitor_lock, pdMS_TO_TICKS(20)) == pdTRUE) {
        n = s_probe_count < max_entries ? s_probe_count : max_entries;
        memcpy(out, s_probe_ssids, n * sizeof(c6_probe_ssid_t));
        xSemaphoreGive(s_monitor_lock);
    }
    return n;
}

int c6_link_monitor_probe_dev_poll(c6_probe_dev_t *out, int max_entries)
{
    if (out == NULL || max_entries <= 0 || !s_monitor_running ||
        s_monitor_lock == NULL) {
        return 0;
    }
    int n = 0;
    if (xSemaphoreTake(s_monitor_lock, pdMS_TO_TICKS(20)) == pdTRUE) {
        n = s_probe_dev_count < max_entries ? s_probe_dev_count : max_entries;
        memcpy(out, s_probe_devs, n * sizeof(c6_probe_dev_t));
        xSemaphoreGive(s_monitor_lock);
    }
    return n;
}
