ErdemWilkinson/makeshift-flipper/MakeshiftFlipper/main/net/c6_transport.c

#include "c6_transport.h"

// No functions defined yet -- see c6_transport.h. Not added to
// main/CMakeLists.txt's SRCS until it has real content (an empty
// translation unit compiles fine, but there's nothing to link against yet).
