ErdemWilkinson/makeshift-flipper/main/ui/menu.h

#pragma once

#include <stddef.h>
#include "input/buttons.h"
#include "display.h"

struct menu_s;

// Called when RIGHT or PRESS is used on a menu item. Mutually exclusive
// with submenu below -- a leaf item has an action, a category item has
// a submenu; a menu_item_t should only set one of the two.
typedef void (*menu_action_fn)(void);

// Optional per-item icon painter. Draws a small glyph into a 16x16 cell whose
// top-left is (x, y). NULL = no icon (label starts at the left as before).
typedef void (*menu_icon_fn)(int x, int y, display_color_t color);

typedef struct {
    const char *label;
    menu_action_fn on_select;   // NULL if this item enters a submenu instead (or is a placeholder)
    struct menu_s *submenu;     // NULL for a leaf item (on_select fires instead)
    menu_icon_fn icon;          // NULL for no icon
} menu_item_t;

typedef struct menu_s {
    const menu_item_t *items;
    size_t item_count;
    int selected_index;
    int scroll_offset;

    // Simple slide-in animation state, advanced by menu_animate_tick().
    int anim_offset_px;   // current vertical pixel offset of the whole list (0 = settled)

    // Set by menu_link_submenu() on the child; NULL for a top-level menu.
    // LEFT walks back up this chain.
    struct menu_s *parent;

    // Optional top row and per-menu colors. Most menus keep a filled
    // selection; Hacking uses red lettering on uninterrupted black.
    const char *banner;
    display_color_t accent_color;
    display_color_t text_color;
    display_color_t selected_text_color;
    bool fill_selection;
    bool has_background_override;
    display_color_t background_color;
} menu_t;

// item_count may be 0 for a category placeholder that isn't wired up yet.
void menu_init(menu_t *menu, const menu_item_t *items, size_t item_count);

// Reserve a non-selectable top row for this menu's centered title.
void menu_set_banner(menu_t *menu, const char *text);

// Set the banner and selected-row color without changing other menus.
void menu_set_accent(menu_t *menu, display_color_t color);

// Override only this menu's text/selection styling.
void menu_set_text_style(menu_t *menu, display_color_t text_color,
                         display_color_t selected_text_color, bool fill_selection);

// Keep this menu's background fixed even when rendered directly after a screen
// that used a different theme.
void menu_set_background(menu_t *menu, display_color_t color);

// Wires parent_item (which must belong to parent->items) to open child when
// selected, and records parent as child's parent so LEFT can back out of
// it later. Must be called after both menus are menu_init()'d.
void menu_link_submenu(menu_t *parent, menu_item_t *parent_item, menu_t *child);

// Aborts (ESP_ERROR_CHECK-style, via assert()) if any item in `menu` has
// both on_select and submenu left NULL -- the one state menu_handle_button()
// silently does nothing for on RIGHT/PRESS (see its "category item that was
// never linked" case). Catches a menu_link_submenu() call that was
// forgotten, or whose hardcoded index drifted out of sync after items were
// reordered (see s_main_menu_items's comment in main.c) -- at boot, with a
// clear assertion failure naming the item, instead of a button that looks
// like it does nothing when a user eventually selects that item. Call once
// per top-level menu, after every menu_link_submenu() for it has run. Does
// NOT recurse into submenus -- call it once per menu_t that exists.
void menu_assert_fully_wired(const menu_t *menu);

// Feeds one button event into the menu (moves selection, fires on_select,
// or enters/exits a submenu) and returns the menu_t that should be
// rendered next (may be `menu` itself, its submenu, or its parent -- never
// NULL). UP/DOWN move the cursor. RIGHT and PRESS activate the selected
// item: for a leaf item this calls on_select (Flipper-style, both do the
// same thing in a flat menu); for a category item this enters its
// submenu. LEFT backs out to the parent menu if one exists (top-level
// menus have no parent, so LEFT is a no-op there). Exiting a screen
// (leaving the menu system entirely) is BUTTON_BACK's job, handled by the
// caller (main.c), not this function.
menu_t *menu_handle_button(menu_t *menu, button_id_t button);

// Advances the entry animation by one frame. Call this every loop tick
// before menu_render(). No-op once the animation has settled.
void menu_animate_tick(menu_t *menu);

// Redraws the menu to the display's frame buffer and flushes it.
void menu_render(const menu_t *menu);
