ErdemWilkinson/makeshift-flipper/main/ui/display.h

#pragma once

#include <stdbool.h>
#include <stddef.h>
#include <stdint.h>

// Waveshare Pico-LCD-1.3 ST7789 SPI LCD, 240x240, RGB565 (65K colors).
// Replaces the earlier
// SSD1306 I2C OLED (128x64, 1-bit) -- see KNOWN_ISSUES.md for the
// migration notes and README.md's pin plan for the new SPI wiring.

#define DISPLAY_WIDTH_PX  240
#define DISPLAY_HEIGHT_PX 240

// 8x16 font (font8x16_basic.h): 240/8 = 30 columns, 240/16 = 15 rows.
#define DISPLAY_ROWS 15
#define DISPLAY_COLS 30

// RGB565: 5 bits red, 6 bits green, 5 bits blue, packed into one uint16_t.
typedef uint16_t display_color_t;

#define DISPLAY_RGB(r, g, b) \
    ((display_color_t)((((r) & 0x1F) << 11) | (((g) & 0x3F) << 5) | ((b) & 0x1F)))

// The device's identity: name shown on the boot splash, the About screen,
// and anywhere else the build wants to brand itself. One place to change
// it for a rebrand/fork.
#define DEVICE_NAME "ErdemFlip"

// The device's color theme -- centralized here (rather than scattered
// display_color_t literals through main.c) so the palette can be reviewed
// or swapped in one place. Values are deliberately high-contrast: this is
// a small 1.3" panel viewed at arm's length, not a phone screen.
//
// Warm red/orange identity (chosen over the earlier green-on-black
// "terminal" look to make this build visually its own): near-black with a
// faint red tint for the background, warm amber body text, and a hot
// red-orange accent for selection/headers -- keeps error red and OK green
// clearly distinct from the accent so status colors still read at a glance.
#define DISPLAY_COLOR_BACKGROUND DISPLAY_RGB(2, 1, 1)       // near-black, faint warm tint
#define DISPLAY_COLOR_TEXT       DISPLAY_RGB(30, 40, 10)    // warm amber
#define DISPLAY_COLOR_ACCENT     DISPLAY_RGB(31, 18, 2)     // hot red-orange -- selection highlight, headers
#define DISPLAY_COLOR_HACKING_ACCENT DISPLAY_RGB(31, 4, 4) // red highlight for Hacking only
#define DISPLAY_COLOR_HACKING_TEXT DISPLAY_RGB(28, 3, 3)   // red text on black
#define DISPLAY_COLOR_HACKING_SELECTED DISPLAY_RGB(31, 16, 16) // brighter red cursor row
#define DISPLAY_COLOR_ACCENT_TEXT DISPLAY_RGB(0, 0, 0)      // text drawn on top of an accent-filled area
#define DISPLAY_COLOR_ERROR      DISPLAY_RGB(31, 4, 4)      // red -- error/failure states
#define DISPLAY_COLOR_OK         DISPLAY_RGB(10, 46, 8)     // green -- success/connected states (kept distinct from accent)
#define DISPLAY_COLOR_DIM        DISPLAY_RGB(14, 10, 4)     // dim warm brown -- secondary/disabled text

// Per-screen background tints. Kept dark so the amber body text stays
// readable; each main category sets one on entry to give the section its
// own identity. Names match the main-menu categories.
#define DISPLAY_BG_DEFAULT   DISPLAY_RGB(5, 0, 8)    // dark purple home screen
#define DISPLAY_BG_RFID      DISPLAY_RGB(1, 3, 6)    // deep blue
#define DISPLAY_BG_INFRARED  DISPLAY_RGB(6, 1, 1)    // deep red
#define DISPLAY_BG_WIFI      DISPLAY_RGB(1, 5, 5)    // deep teal
#define DISPLAY_BG_BLUETOOTH DISPLAY_RGB(2, 2, 7)    // deep indigo
#define DISPLAY_BG_SECURITY  DISPLAY_RGB(5, 4, 0)    // deep olive/gold
#define DISPLAY_BG_HACKING   DISPLAY_RGB(0, 0, 0)    // black, with red text
#define DISPLAY_BG_ERRORS    DISPLAY_RGB(6, 3, 0)    // deep amber/brown
#define DISPLAY_BG_ABOUT     DISPLAY_RGB(3, 3, 4)    // cool slate

// Sets the active background color used by display_clear() and the text
// helpers. Screens call this to retint the whole UI before drawing.
void display_set_background(display_color_t color);
display_color_t display_get_background(void);

// Brings up SPI + the ST7789 panel. Call once at startup.
void display_init(void);

// Clears the internal frame buffer to DISPLAY_COLOR_BACKGROUND (does not
// push to the panel yet).
void display_clear(void);

// Draws text at a character cell (row/col), 8x16 font, in `color` on the
// current background. Truncates at DISPLAY_COLS. This is the call most of
// main.c uses; use display_draw_text_color() to pick a color explicitly
// (this is a thin wrapper for DISPLAY_COLOR_TEXT, the common case).
void display_draw_text(int row, int col, const char *text);
void display_draw_text_color(int row, int col, const char *text, display_color_t color);
// Centers UTF-8 text by display glyphs (not byte length).
void display_draw_text_centered(int row, const char *text, display_color_t color);

// Draws text at an arbitrary pixel position (not grid-snapped), in `fg` on
// a `bg`-filled cell background (both explicit -- there is no invert/XOR
// mode on a color panel, unlike the old 1-bit display_draw_text_px()).
// Used by menu.c/text_entry.c for the selection highlight and animations.
void display_draw_text_px(int x, int y, const char *text, display_color_t fg, display_color_t bg);

// Fills a solid rectangle with `color` (used for the selection highlight
// and status bars/badges).
void display_fill_rect(int x, int y, int w, int h, display_color_t color);

// Pixel/vector primitives for freeform screens (e.g. the BLE radar). All clip
// to the panel per pixel, so off-screen coordinates are harmless.
void display_draw_pixel(int x, int y, display_color_t color);
void display_draw_line(int x0, int y0, int x1, int y1, display_color_t color);
void display_draw_circle(int cx, int cy, int r, display_color_t color);   // outline
void display_fill_circle(int cx, int cy, int r, display_color_t color);   // solid disc

// Pushes the internal frame buffer to the physical panel.
void display_flush(void);
