ErdemWilkinson/makeshift-flipper/(commit log)

2026-09-17 Initial commit: Makeshift Flipper firmware skeleton
    ESP32-P4 main firmware + ESP32-C6 Wi-Fi companion, OLED menu, RFID/NFC
    (RC522 + RDM6300), IR NEC transceiver, analog joystick input, and
    web/joystick-based Wi-Fi setup flows.
    [buttons.c, buttons.h, c6_link.c, c6_link.h, display.c, display.h, ir_driver.c, ir_driver.h]
2026-09-17 Fix joystick calibration robustness (Round 7 review findings)
    calibrate_center() now warns on a noisy/off-center boot calibration and
    clamps the computed center away from both ADC rails, closing the
    degenerate-trigger-window risk noted in the same review round.
    [buttons.c]
2026-09-17 Clarify hardcoded AP password risk now that the repo is public
    The password was previously framed as recoverable "by decompiling the
    firmware" -- now that the source is public, it's just plainly visible.
    Adds an explicit pointer to change AP_PASSWORD before relying on it.
2026-09-17 Restore Ask AI feature (Ollama bridge) that was left in a stash
    Was staged/uncommitted in the working tree from another session and got
    temporarily stashed while syncing the architecture-diagram change; this
    recovers it and merges its README updates with the diagram swap.
    [c6_link.c, c6_link.h, main.c]
2026-09-17 Add menu category tree and IR direction finding
    Menu goes from one flat list to categories (RFID/NFC, Infrared, WiFi)
    each opening its own submenu, via a small parent/child extension to
    menu_t (menu_link_submenu(), LEFT walks back up). Also adds
    ir_direction.c/h: 4 independent VS1838B receivers (GPIO5/6/14/15) report
    coarse N/E/S/W quadrant flags for an incoming NEC transmission, wired
    into the menu as "IR Direction Find" under Infrared. Needs the 4-receiver
    hardware and hasn't been tested on real hardware yet -- see
    KNOWN_ISSUES.md's Round 8 entry for open questions (RMT channel budget
    in particular).
2026-09-17 Fix 4 cheap known-issue items + move OLLAMA_HOST to Kconfig
    - ir_driver.c: RX queue depth 1 -> 3, so back-to-back IR bursts don't
    silently overflow and drop.
    - menu.c: menu_render() now truncates an over-length label with a
    trailing "..." instead of silently cutting it off.
    - ir_direction.c: one-line comment noting GPIO5/6 sit in the scarce
    ADC1-only GPIO0-6 range (no pin change, just documents the tradeoff).
    - wifi_commands.c: OLLAMA_HOST/PORT/MODEL moved from hardcoded #defines
    to a new Kconfig.projbuild ("idf.py menuconfig"), and
    ASK_RESPONSE_BUF_LEN bumped 4096 -> 16384 bytes so longer Ollama
    replies stop silently truncating mid-JSON. Neither fully removes the
    underlying ri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
    [ir_direction.c, ir_driver.c, menu.c]
2026-09-17 Update README's stale OLLAMA_HOST reference to point at Kconfig
    Next-steps item 9 still described the old hardcoded #define; it now
    points at idf.py menuconfig / Kconfig.projbuild, matching the actual
    current setup.
2026-09-17 Switch Ask AI to qwen3:8b, disable thinking mode for latency
    Tested qwen2.5vl:3b vs qwen3:8b locally: qwen3:8b gives noticeably better
    Turkish answers. But Qwen3's thinking mode (Ollama's default) adds ~50s of
    extra latency before the answer even starts -- measured 54s vs 4s for the
    same prompt with "think": false. That's dangerously close to this
    project's own OLLAMA_TIMEOUT_MS (60s) and c6_link's ASK_TIMEOUT_MS (70s),
    so the request body now explicitly disables it.
2026-09-17 Wire up automatic Debug AI background task, drop physical DEBUG button
    Replaces the physical DEBUG button with a background FreeRTOS task
    (debug_ai_task) that polls diag_get()'s seq counter and automatically
    sends any new error to the debug_server.py/Ollama pipeline, delivering
    the verdict back to the main loop via a depth-1 queue so the ~65s
    network call never blocks the joystick/menu. Adds the missing
    xQueueCreate()/xTaskCreate() calls in app_main() and a missing
    string.h include that the button removal's leftover strcmp/strncpy
    calls needed. Updates KNOWN_ISSUES.md's Round 9 entry and the Kconfig
    help text to match the new automatic architecture.
    [main.c]
2026-09-17 Make Debug AI fully automatic, remove the manual DEBUG button
    User wants error reports sent to the AI the moment something goes wrong,
    not via a manual button press. Removed the leftover duplicate
    debug_ai_task_fn()/queue-creation code from an in-progress edit (this
    session and another running in parallel both independently converged on
    the same "background task + queue" design; kept the more complete version
    with the mutex-safety comment and de-duplicated the rest). Updated
    README.md and c6-firmware/README.md to describe the automatic behavior
    instead of the old physical DEBUG button (GPIO16), which no longer exists.
    [c6_link.c, c6_link.h, main.c]
2026-09-17 Add RFID card cloning, Wi-Fi Monitor, and BT Scan features
    RC522 gains write/clone support for MIFARE Classic cards. The C6
    companion firmware adds passive Wi-Fi beacon/probe monitoring
    (wifi_monitor.c) and passive BLE advertisement scanning (bt_scan.c),
    both receive-only by design (no injection, no deauth, no GATT
    connection). uart_link.c gets the plumbing these new unsolicited
    push-style commands need alongside the existing request/response ones.
2026-09-17 Replace Ask AI / Debug AI with on-device error history + optional send
    Remove the Ollama-based Ask AI and automatic Debug AI features
    entirely -- they required a PC running Ollama reachable over Wi-Fi at
    all times, made the device's setup and normal operation depend on
    that PC being up, and added real latency to a handheld tool.
    Replace with a fully offline error history: diag.c/h now keep a
    24-entry ring buffer of recent errors (module, code, boot-relative
    timestamp) instead of a single last-error slot, browsable from a new
    "Errors" menu with no network involved. Sending that history anywhere
    is now optional: pressing a button on that screen streams the entries
    to the C6 over UART (LOGSEND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
    [c6_link.c, c6_link.h, main.c]
2026-09-17 Remove dead answer_view scrollable text viewer
    Its only caller was Ask AI, which was removed in 9d8b15b. It was still
    listed in main/CMakeLists.txt's SRCS and still compiling, but nothing
    in the current build referenced it -- flagged during a KNOWN_ISSUES.md
    cleanup pass by makeshift-flipper-8b. The new "Errors" screen rolls its
    own display logic, so there's no remaining use for a generic
    scrollable text viewer.
2026-09-18 Fix build errors found compiling both firmwares for real hardware
    First actual idf.py build of this repo (previously never compiled,
    per KNOWN_ISSUES.md). Fixes needed to get both P4 and C6 firmware to
    build clean under ESP-IDF v5.3.1:
    - main/ui/display.c: wrong header name (esp_lcd_ssd1306.h) and a
    stale external component_manager dependency in idf_component.yml
    for a driver that's actually built into ESP-IDF's own esp_lcd
    component as esp_lcd_panel_ssd1306.h -- not a separate package.
    - main/main.c: six -Werror=format-truncation errors from snprintf
    precision values that didn't guarantee staying within their
    destination buffers (WiFi Monitor/BT Scan/WiFi Setup/Errors list
    rows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
    [display.c, main.c]
2026-09-18 Add host-side logic tests and GitHub Actions CI
    Extract hardware-independent pure logic into its own modules so it can
    be tested with a plain host compiler, no ESP-IDF toolchain needed:
    - main/net/json_escape.c/.h: JSON string escaping, pulled out of
    c6_link.c (was a static function embedded in a file otherwise full
    of UART/FreeRTOS dependencies).
    - c6-firmware/main/text_sanitize.c/.h: wire-text sanitizing and BLE
    advertising-data name parsing, pulled out of wifi_monitor.c and
    bt_scan.c (previously near-duplicated between the two files).
    tests/ holds a minimal single-header test harness (no Unity/CMock
    dependency) plus 4 test files (61 checks total) that #include the
    real source fi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
2026-09-18 Replace fixed WiFi setup AP password with a per-session random PIN
    A security review of c6-firmware/main/wifi_setup_ap.c (prompted by
    step 4 of the roadmap -- WiFi setup security) found that the setup
    AP's WPA2-PSK password was a fixed string ("flipper123") compiled
    into the public firmware source: identical across every unit built
    from this repo, and visible in plaintext to anyone reading the code.
    Combined with AP_MAX_CONN=1's enforcement gap -- it only blocks a
    second association while the legitimate client stays associated, so
    a transient drop between the setup page loading and the form being
    submitted leaves a window where a second attacker who already knows
    the fixed password could ass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
    [c6_link.c, c6_link.h, main.c]
2026-09-18 Persist the on-device error history to NVS across reboots
    diag.c's ring buffer was RAM-only (per its own comment: "not persisted
    across a reboot"), so a battery pull or crash lost the whole "Errors"
    history a user might want to check. Adds diag_load()/diag_save(),
    explicit rather than automatic -- diag_record_error() itself still
    never touches flash, so a burst of failures (e.g. repeated failed RFID
    reads) doesn't wear out the NVS partition. main.c calls diag_load()
    once at boot (before anything else can record an error) and
    diag_save() when the user exits the "Errors" screen, which bounds
    flash writes to "once per Errors-menu visit" rather than "once per
    error."
    A size/layout mismatch in t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
    [main.c, test_diag.c]
2026-09-20 Add RFID UID library, fix host test include paths and hardware test matrix
    RFID/NFC:
    - main/rfid/rfid_library.c/.h: named library for scanned tag UIDs
    (RDM6300 125kHz and RC522 13.56MHz), NVS-persisted, mirroring the
    existing main/ir/ir_library.c shape. Deliberately UID-only -- unlike
    RFID Clone's one-shot sector dump, nothing here can reproduce a
    card's Mifare data, only recognize a previously-seen UID.
    - main/main.c: "Save 125kHz"/"Save 13.56MHz" (capture -> name -> save,
    reusing a new shared prompt_for_name() helper also adopted by
    action_ir_learn()) and "RFID Library" (browse/delete, up to 16
    entries total) menu actions. rfid_library_load() added to app_main().
    - main/CMake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
    [display.c, ir_direction.c, main.c, rfid_library.c, rfid_library.h, test_ir_library.c, test_rfid_library.c]
2026-09-20 Switch display from SSD1306 OLED to ST7789 SPI LCD, polish menu/UI colors
    Hardware change: target display is now a 1.8" ST7789 SPI LCD, 240x240,
    RGB565 (65K colors), replacing the earlier 128x64 monochrome SSD1306 I2C
    OLED. This is a ground-up rewrite of the display layer, not a config
    tweak -- see KNOWN_ISSUES.md's Round 15 for the full rationale and caveats.
    Display layer (main/ui/display.c/.h):
    - Drives the panel over SPI via esp_lcd_new_panel_st7789() (built into
    ESP-IDF's esp_lcd component, no extra managed component needed)
    - New SPI pin plan on its own bus (SPI3_HOST, separate from RC522's
    SPI2_HOST): SCK=GPIO7, MOSI=GPIO8 (both freed by removing I2C),
    CS=GPIO14, DC=GPIO15, RST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
2026-09-20 Follow-up cleanup pass: close out several Round 13/15 known issues
    - IR Direction Find no longer hangs on "Waiting for IR..." forever when
    disabled: added ir_direction_is_available() (main/ir/ir_direction.h/.c)
    so main.c's render_ir_direction_screen() can show an explicit "Not
    available on this build" message with the reason (RMT channels already
    used by IR RX/TX), instead of leaving the user on a screen that can
    never report anything. The underlying GPIO/RMT-channel constraint is
    unchanged -- this only fixes the silent-hang UX.
    - Added sdkconfig.defaults (repo root) setting
    CONFIG_ESPTOOLPY_FLASHSIZE_32MB=y, matching the 32MB flash chip Round
    13's hardware bring-up actually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
    [ir_direction.c, ir_direction.h, ir_driver.c, main.c]
2026-09-20 docs: add Turkish ASR stage 2 report
2026-09-20 Give the device its own identity: ErdemFlip name + warm red/orange theme
    - main/ui/display.h: added DEVICE_NAME ("ErdemFlip") and replaced the
    green-on-black "terminal" palette with a warm red/orange one --
    near-black background with a faint warm tint, amber body text, and a
    hot red-orange ACCENT for selection/headers. ERROR/OK stay clearly
    distinct from ACCENT so status colors still read at a glance. menu.c
    and text_entry.c needed no changes since they already reference the
    DISPLAY_COLOR_* macros rather than hardcoding values.
    - main/main.c: added render_boot_splash() (accent bar + centered
    DEVICE_NAME + tagline, held ~1.5s), called once from app_main() right
    after display_i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
    [display.h, main.c]
2026-09-20 Document OCR/voice TinyML companion projects' current quality status
    Neither ocr/ nor voice/ has a results section anyone had read end-to-end:
    OCR has no measured accuracy at all (and no camera/TinyML runtime in this
    firmware to run it on), the voice command classifier (the actual ship
    target) hasn't been trained because its dataset isn't recorded yet, and
    the voice CTC research baseline that IS trained scores badly (59-65% CER)
    but is explicitly marked as not the deployment target. Recorded as a new
    round so this is visible from the firmware side too.
2026-09-20 Round 18: fix 3 code-fixable KNOWN_ISSUES.md items
    - main/ui/menu.c/.h: added menu_assert_fully_wired() -- walks a menu's
    items and assert()s none has both on_select and submenu NULL (the
    state menu_handle_button()'s RIGHT/PRESS case silently does nothing
    for). Called once on s_main_menu in app_main(), right after all four
    menu_link_submenu() calls. A forgotten or misindexed
    menu_link_submenu() call now fails loudly at boot instead of leaving
    a menu item that silently does nothing when a user eventually
    selects it.
    - main/ui/menu.c: added a comment above menu_handle_button()'s
    `menu_t *next = menu;` spelling out the mutate-in-place-vs-return-a-
    different-pointer split the f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
    [main.c, menu.c, menu.h]
2026-09-20 Add camera/TinyML integration plan, update Round 17 with measured OCR results
    Ran ocr/scripts/evaluate.py for the first time: CER 13.09%, exact-line
    accuracy 57.35% on 3681 held-out samples -- below ocr/README.md's
    acceptance bar but not garbage (mostly small errors, not wholesale
    mangling like voice/'s CTC baseline). Added HARDWARE_INTEGRATION_PLAN.md
    covering camera module choice (OV2640/DVP), TinyML runtime choice
    (TFLite Micro), pin budget (camera's 8-bit bus doesn't currently fit the
    documented free-pin range), memory budget unknowns, and a build order
    that surfaces hardware unknowns before writing integration code.
2026-09-21 Document Round 18: an incomplete voice CTC training run + evaluate_asr.py bug
    Found artifacts/asr_common_voice_full_v3/ already on disk with a mid-
    training checkpoint (best_training.keras) but no inference.keras -- the
    run was cut short before finishing, so it can't be scored yet. Also
    confirmed a bug in the newly-added evaluate_asr.py: it loads .keras files
    without the custom_objects needed to deserialize training.py's CtcLoss
    layer, so it can't load a training-format checkpoint like this one (the
    already-reported stage0-2 CER/WER numbers are unaffected since those used
    properly-saved inference.keras files via a different, working path).
2026-09-21 Rewrite README intro/quickstart, fix system-overview image path
    - New opening paragraph describes what the device does and who it's
    for instead of just listing hardware; added a "Prototype status"
    callout and a "Run it" section with the actual idf.py build/flash
    commands up front.
    - Point the system overview image at docs/makeshift-flipper-system-overview.png
    (higher-res replacement) and remove the old root-level PNG it
    replaced, which was no longer referenced from anywhere.
2026-09-21 Fix list screens overwriting their footer past 7 entries
    Six screens (RFID Library, IR Library, Errors, WiFi Monitor, BT Scan,
    and the WiFi Setup Manual network picker) drew their list body across
    rows 1..(DISPLAY_ROWS-2) -- i.e. up to row 13 -- while a fixed-text
    footer/hint line was drawn separately at hardcoded row 7. Every one of
    these lists can hold more than 6 entries (RFID/IR libraries: 16, Errors:
    DIAG_HISTORY_CAPACITY=24, WiFi Monitor/BT Scan: 32, network picker: 16),
    so the 7th+ list row silently painted over the footer text instead of
    the other way around -- worse, since list rows are drawn after the
    footer's row 7 would have been, the footer was gone entirely as soon as
    there wer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
    [main.c]
2026-09-21 Fix Round 19's 3 findings: netif reuse, partial HTTP body, unchecked xTaskCreate
    Addresses the three source-level findings the uncommitted "Round 19"
    KNOWN_ISSUES.md draft documented but hadn't fixed:
    - wifi_setup_ap_run() called esp_netif_create_default_wifi_ap() on every
    SETUP:<pin> command with no way to destroy or reuse the previous one.
    WiFi Setup is an ordinary, repeatable P4 menu action, so a second
    attempt after a cancelled/timed-out/failed first one would try to
    create the same default AP netif twice. Now created once, lazily, into
    a static s_ap_netif and reused on every later call.
    - connect_post_handler() made exactly one httpd_req_recv() call and
    trusted whatever by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
    [c6_link.c]
2026-09-21 Fix Round 19's remaining 4 findings: NFC save hang, held-card flood, SSID sanitization
    Addresses the four findings from the uncommitted "Round 19" KNOWN_ISSUES.md
    draft not covered by the earlier netif/HTTP-body/xTaskCreate fix commit:
    - action_rfid_save_1356mhz() (via the shared wait_for_card() helper) only
    ever returned true for RC522_SCAN_OK, so a 7/10-byte-UID card
    (RC522_SCAN_UNSUPPORTED_UID -- rc522.c only implements cascade level 1)
    made "Present tag now" hang forever with no way out but BACK, despite
    the screen's own header comment claiming 7/10-byte support. Same latent
    hang existed in RFID Clone's two wait_for_card() calls. Now
    wait_for_card() reports the unsupported c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
    [main.c]
2026-09-21 Fix Round 19's 3 async-session race conditions: stop-reply and start-reply desync
    Addresses the three concurrency findings the other review pass added to
    the uncommitted KNOWN_ISSUES.md draft after reviewing the earlier
    Round 19 fix commits:
    - Stop-reply desync: monitor_rx_task()/bt_scan_rx_task() sent
    MONITORSTOP/BTSCANSTOP and trusted exactly one subsequent line to be
    the reply. The C6's PKT:/BTDEV: producer task keeps independently
    draining its queue until wifi_monitor_stop()/bt_scan_stop() actually
    runs on the C6's dispatch loop, so a queued data line can legitimately
    arrive first -- consuming it in place of the real OK/FAIL reply leaves
    that reply sitting in the UART for th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
    [c6_link.c]
2026-09-21 Add launch/compliance docs, replace overview image, mark Round 19 fixed
    - SHARING.md: launch checklist and draft posts (Reddit/HN/Twitter/
    LinkedIn) for once the device is hardware-validated, including a
    reminder to keep the prototype-status disclaimer and to never post
    third-party card/Wi-Fi/IR data.
    - YETENEK_VE_UYUM_DEGERLENDIRMESI.md: capability/use-boundary/added-
    component risk assessment (authorized-use framing, misuse classes,
    and safe product boundaries for each existing and potential feature)
    -- a risk inventory, not an attack guide.
    - OCR_TRAINING_SLOWDOWN_REPORT.md: local investigation into why OCR
    training was intermittently very slow on this machine (Bitdefender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
2026-09-21 Start RP2040/Pico port: Phase 1 (display+buttons+menu) + docs
    Begins the migration of the main MCU from ESP32-P4 (ESP-IDF) to
    Raspberry Pi Pico (RP2040, Pico SDK) to use the Waveshare Pico-LCD-1.3
    display module's built-in digital 5-way joystick, dropping the
    separate analog joystick. main/ (ESP32-P4) and c6-firmware/ (ESP32-C6
    companion, unchanged) are untouched by this work.
    New pico/ tree, Phase 1 scope:
    - main/input/buttons.c/h: rewritten for the module's 6 digital GPIOs
    (5-way joystick + B=BACK), same button_id_t/buttons_poll() contract
    as the P4 build so menu.c/text_entry.c need no changes
    - main/ui/display.c: hand-rolled ST7789 init/flush over Pico SDK's
    hardware/spi.h, replaci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
2026-09-21 README: add responsible-design capability table
    Adds a "Built to stay on the right side of the line" table summarizing
    what each capability deliberately does NOT do (no deauth/injection, no
    GATT/pairing, no general card emulation, no cloud telemetry, etc.),
    framed positively for anyone evaluating the project rather than as a
    threat-model writeup. Derived from the existing capability/use-boundary
    assessment, no new claims beyond what that document already documents.
2026-09-21 README: lead with responsibility disclaimer, add misuse-boundary table
    Moves the responsibility disclaimer to the top of the README (right
    after the intro, before the prototype-status notice) and replaces the
    earlier "deliberately doesn't do" table with a 3-column table: per
    capability, the legitimate/authorized use vs. what's technically
    possible with the same hardware but unauthorized/unlawful, framed as
    an explicit "do not do this" list rather than a feature spec. Derived
    from the existing capability/use-boundary assessment, no new claims.
2026-09-21 Fix P4 build: wait_for_card() called display_draw_text() with 4 args
    display_draw_text(row, col, text) takes no color argument -- only
    display_draw_text_color(row, col, text, color) does. The "7/10-byte
    UID not supported" message in wait_for_card() (added during the
    Round 19 hang fix) called the former with a color argument, which
    doesn't compile: "too many arguments to function 'display_draw_text'".
    This was breaking CI's P4 build on every push since that fix landed.
    Switch it to display_draw_text_color(), matching the line right above
    it.
    [main.c]
2026-09-21 Fix Round 21/23 NULL-handle and stop-race findings; mark KNOWN_ISSUES.md fixed
    Firmware changes (Round 21/23 from KNOWN_ISSUES.md):
    - main/net/c6_link.c: c6_link_init()'s xSemaphoreCreateMutex() result is
    now NULL-checked; a new link_ready() gate makes every public
    c6_link_*() call fail safely (instead of blocking forever on a NULL
    mutex) if link init didn't complete. s_monitor_data_mutex's lazy
    creation is also NULL-checked.
    - c6-firmware/main/uart_link.c: uart_link_init()'s write-mutex creation
    is NULL-checked; uart_link_write_line() now refuses to dereference a
    NULL mutex instead of assuming it always exists.
    - c6-firmware/main/wifi_monitor.c, bt_scan.c: wifi_monitor_init()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
    [c6_link.c]
2026-09-21 Fix Round 24/25 KNOWN_ISSUES.md findings: real host-test coverage, OCR docs, UI feedback
    Round 24 (missing-test and workflow self-audit):
    - tests/test_wifi_pkt_parse.c contained its own copied parser instead of
    testing production code. Extracted the PKT: line parsing logic out of
    main/net/c6_link.c's handle_pkt_line() into a new standalone module,
    main/net/pkt_line_parse.c/h (same pattern as json_escape.c -- pure, no
    FreeRTOS/UART dependency), which handle_pkt_line() now calls directly.
    Rewrote the test to #include the real source file, matching every
    other test in the suite, and added 3 new cases (missing prefix,
    malformed BSSID, SSID truncation) the old copy never covered. A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
    [c6_link.c, main.c, pkt_line_parse.c, pkt_line_parse.h, test_text_entry.c, test_wifi_pkt_parse.c, text_entry.c]
2026-09-22 Add empty skeleton files for future Wi-Fi/RFID/IR/security-menu tooling
    Matches a requested main/ module layout (net/, rfid/, ir/, ui/, diag/,
    main.c, CMakeLists.txt), which the tree already had. Adds 4 new
    placeholder module pairs, each with a doc comment explaining its scope
    and pointing at the existing driver/library module it builds on, and
    what to add once a real feature is specified -- no functions defined
    yet, so none are added to main/CMakeLists.txt's SRCS until they have
    real content:
    - main/net/wifi_tools.c/h -- Wi-Fi research/utility functions on top of
    c6_link.h's existing scan/monitor/setup API
    - main/rfid/rfid_tools.c/h -- RFID/NFC tooling on top of
    rc522.h/rdm6300.h/rfid_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
2026-09-22 Add more empty skeleton files: wifi_scan_client, c6_transport, wifi_scan_screen, C6-side wifi_scan/protocol
    Continues the placeholder module set from the previous commit, for a
    requested finer-grained split of the existing Wi-Fi scan path -- no
    functions defined yet in any of these, each has a doc comment
    explaining what it would eventually hold and which existing file it
    would be carved out of:
    - main/net/c6_transport.c/h -- low-level P4<->C6 UART transport (would
    eventually hold c6_link.c's send_line()/read_line() plumbing)
    - main/net/wifi_scan_client.c/h -- P4-side SCAN-specific protocol
    client (would eventually hold c6_link.c's c6_link_scan())
    - main/ui/wifi_scan_screen.c/h -- stand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
2026-09-23 Makeshift Flipper: two-chip -> single-MCU ESP32-C6 standalone
    Big architecture change. The device used to be a two-chip design
    (ESP32-P4 main MCU + ESP32-C6 radio companion over UART). It is now a
    single ESP32-C6 that runs the whole UI and the radio directly -- no
    second chip, no UART link. The freed P4 goes to a separate lab/TinyML
    project.
    What changed:
    - On-chip radio: Wi-Fi (init/scan/manual-connect/promiscuous monitor) in
    main/net/c6_link.c and passive BLE advertisement scan (NimBLE) in
    main/net/radio_ble.c, filling the same c6_link_* API the UI always
    called. The old UART transport is gone.
    - Retargeted every driver to C6 pins: shared SPI2 bus (display + RC522
    with separate CS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
    [partitions.csv]
2026-09-23 Add root README landing page pointing to MakeshiftFlipper/
    The firmware README moved into MakeshiftFlipper/ during the reorg, leaving
    the repo root without a README so GitHub showed "Add a README". This adds
    a short root landing page: the one-line project summary, the two-chip ->
    single-C6 note, links into MakeshiftFlipper/ (full README, hardware plan,
    capability assessment, architecture decision), and the responsibility
    boundary.
2026-09-23 Flatten firmware to repo root (drop MakeshiftFlipper/ subfolder)
    The firmware lived under MakeshiftFlipper/ with a thin landing README at
    the root, so GitHub's front page showed the landing page instead of the
    project README. Move everything up one level so the firmware IS the repo:
    the real README, CMakeLists, main/, tests/, docs/, and all hardware docs
    now sit at the root. Removed the extra root landing README.
    Also updated the paths that referenced the subfolder:
    - .gitignore: build/, tests/.build/, sdkconfig etc. without the prefix.
    - .github/workflows/build.yml: build path '.' and tests/run_tests.sh.
    In-doc links were already relative, so nothing else changed.
    [partitions.csv]
2026-09-23 Revert flatten: keep firmware under MakeshiftFlipper/ subfolder
    Undo the two previous commits (flatten-to-root + root landing README).
    The repo root is the larger PROJELER workspace; the shared firmware is the
    MakeshiftFlipper/ subfolder, so the firmware stays under MakeshiftFlipper/
    with its README inside it -- not flattened to the root.
    Reverts 45a9cc19 and 5b3ccf3c, restoring the 240c1495 layout:
    firmware + README under MakeshiftFlipper/, .gitignore and CI paths
    prefixed with MakeshiftFlipper/ again.
    [partitions.csv]
2026-09-23 Flatten firmware to repo root; drop MakeshiftFlipper/ subfolder
    The workspace root is used only for the shared GitHub repo, and OCR/ASR
    are being split out into their own separate projects (voice/, ocr/, both
    already independent git repos with their own remotes). With those two
    carved out, the firmware becomes the whole repo, so it moves up from
    MakeshiftFlipper/ to the root: README (with the C6 block-diagram image),
    CMakeLists.txt, main/, tests/, docs/, and all hardware/capability docs.
    Updated the paths that referenced the old subfolder:
    In-repo do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
    [partitions.csv]
2026-09-23 Update README technical-overview diagram (cleaner render)
    Replaces the previous C6 block diagram with a cleaner version: the
    battery icon renders correctly now instead of leaking "battery symbol,
    VBUS" as text.
2026-09-23 Fix all 5 confirmed Round 27 findings in KNOWN_ISSUES.md
    Real fixes, not just documentation -- verified with a clean idf.py build
    (esp32c6) and the full host test suite (all 7 suites, 208 checks, 0 failed)
    after every change below.
    - Rewrote HARDWARE_TEST_MATRIX.md from scratch against the real C6 pin
    definitions in main/ and C6_STANDALONE_HARDWARE_PLAN.md. It previously
    still prescribed the retired P4 pin map (LCD SCK/MOSI GPIO7/8, RC522
    GPIO9-13, RDM6300 GPIO17, ADC joystick) and asked testers to verify
    removed features (SoftAP setup, Errors->Send). Following it as written
    could cause real miswiring or a false pass/fail report.
    - Marked the two known-dead menu items directly in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
    [c6_transport.c, c6_transport.h, wifi_scan_client.c, wifi_scan_client.h, wifi_tools.c, wifi_tools.h]
2026-09-23 Recommit Round 27 fixes + add STA/MON mode labels to Wi-Fi screens
    The previous commit (bc91c714, "Fix all 5 confirmed Round 27 findings")
    was supposed to contain the real fixes to HARDWARE_TEST_MATRIX.md,
    KNOWN_ISSUES.md, main/main.c, main/net/c6_link.c, main/net/json_escape.h,
    main/net/pkt_line_parse.h, and tests/test_wifi_pkt_parse.c, but somehow
    landed with the pre-fix content for most of those files even though the
    disk had the corrected versions (verified: disk had s_connect_pending,
    the [STA]/[MON] groundwork, the rewritten pin map, etc. the whole time --
    this commit just makes HEAD match what was actually on disk and already
    verified with a clean idf.py build + full host test pass).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
    [c6_link.c, json_escape.h, main.c, pkt_line_parse.h, test_wifi_pkt_parse.c]
2026-09-23 Mark Round 26's 7 findings as fixed -- verified against current source
    All seven Round 26 findings were already fixed in code; this file just
    hadn't been updated to say so. Re-checked each one directly against the
    current source (not old notes) before marking it:
    - Back button: menu_handle_button() already shares BUTTON_LEFT/BUTTON_BACK
    in one case, covered by tests/test_menu.c's back_button_returns_to_parent.
    - Wi-Fi Setup 6-minute trap: moot after the C6-standalone migration --
    c6_link_setup() is a non-blocking stub now, nothing to get stuck in.
    - Scan failures shown as empty: c6_link_scan() already returns -1 for
    every real failure, 0 only for a genuine empty scan; both callers
    b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
2026-09-23 Wi-Fi Monitor: add vendor labels and channel quarantine
    Two passive, receive-only additions to the existing Live TUI-style scan
    screen -- no new capability class, both derive purely from data the
    monitor already receives.
    - Vendor label: each listed AP now shows a short manufacturer label
    (e.g. "TP-Link", "RPi") derived from its BSSID's OUI (first 3 bytes)
    against a small built-in table (~25 common vendors), falling back to
    "?" for anything not listed. Purely a local, static lookup against
    publicly-registered IEEE OUI prefixes -- identifies hardware, not a
    person, and nothing leaves the device. New c6_monitor_ap_t.vendor
    field, filled in monitor_rx_cb() via oui_vendor_lookup().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
    [c6_link.c, c6_link.h, main.c]
2026-09-23 Remove remaining literal P4 mentions from main/ comments
    Full case-insensitive search of main/, main/CMakeLists.txt,
    sdkconfig.defaults, partitions.csv, and .github/ for "P4"/"ESP32-P4"
    turned up two remaining literal mentions, both in explanatory comments
    (no code/config dependency on P4 anywhere -- confirmed no build files,
    pin definitions, or CI config referenced it). Reworded both to describe
    the retired architecture as "the former two-chip, UART-linked design"
    instead of naming the P4 chip specifically:
    - c6_link.c's file-header comment ("P4-side client" -> "UI-side client",
    "old c6-firmware/ UART handlers" -> "old radio-side UART handlers")
    - c6_link.h's API comment ("former P4-to-C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
2026-09-24 First real ESP32-C6 hardware bring-up: fix RMT boot abort, find GPIO16 hang
    Flashed the standalone firmware to a real ESP32-C6-MINI-1 board
    (Waveshare ESP32-C6-Pico) for the first time and watched it boot over
    serial. Bare module only -- no LCD/RC522/RDM6300/button expander/IR
    wired up yet, so this confirms boot robustness and on-chip Wi-Fi/BLE
    bring-up, not any external peripheral's actual function.
    Found and fixed one real, unconditional boot-abort bug:
    - ir_driver.c's mem_block_symbols=128 for both RMT channels rounds up to
    3 memory blocks (SOC_RMT_MEM_WORDS_PER_CHANNEL=48 on this chip), wider
    than the 2 RX candidate slots ESP-IDF's rmt_rx_register_to_group() will
    ever scan -- so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
    [ir_driver.c, main.c]
2026-09-24 Fix RDM6300/UART1 watchdog hang: enable UART1 function clock
    rdm6300_init() tripped the interrupt watchdog on real ESP32-C6 hardware,
    inside uart_driver_install(). addr2line placed the hang in uart_ll_update()
    -- the busy-wait that syncs a register write into the UART core-clock
    domain, which only clears while UART1's function clock (PCR sclk_en) is
    running. ESP-IDF v5.3.1 enables a secondary HP UART's bus clock but never
    its function clock; UART0 works only because the ROM left its clock on.
    Enable UART1's source + function clock ourselves before uart_driver_install,
    inside the RCC-atomic section the shared PCR register requires. RX pin moved
    to GPIO1 (Pico GP28), the hardware plan's confi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
    [main.c, rdm6300.c]
2026-09-25 Hardware bring-up: direct-GPIO buttons, screen rotation, per-menu colors
    Validated on real ESP32-C6-DEV-KIT-NX + Waveshare Pico-LCD-1.3.
    - buttons: the Pico-LCD-1.3 breaks every control out to its own pin (no
    TCA9554 expander), so replace the I2C-expander path with four direct
    GPIO inputs -- UP(IO4), DOWN(IO6), RIGHT(IO22)=enter, LEFT(IO7)=back.
    Removes the boot-time I2C NACK spam from probing a chip that isn't there.
    - display: rotate 90 degrees (swap_xy + mirror) since the device is held
    in landscape; UI now renders upright.
    - display/menu/main: runtime-settable background color; each main category
    carries its own tint (RFID blue, IR red, WiFi teal, BT indigo, Security
    green,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
    [buttons.c, buttons.h, display.c, display.h, main.c, menu.c]
2026-09-27 Add Wi-Fi QR sharing; clean up button diagnostics
    - ui/qrcode.{c,h}: minimal dependency-free QR generator (byte mode, ECC
    level M, versions 1-10, Reed-Solomon + mask selection). No static RAM
    cost; renders straight into the framebuffer.
    - WiFi Ağım (SoftAP) screen: UP now shows a Wi-Fi-join QR
    (WIFI:T:WPA;S:..;P:..;;) on a white quiet-zone field, so a phone scan
    joins the AP without typing the password.
    - buttons.c: remove the temporary DIAG serial logging added during the
    hardware button bring-up.
    Also folds in the concurrent radio/doc changes (c6_link, radio_ble,
    README, HARDWARE_TEST_MATRIX) so the tree matches the verified build.
2026-09-27 Add passive Wi-Fi channel map, frame stats, and BLE beacon decoding
    Implements the three remaining self-contained features from
    SESSION_04's backlog. All are receive-only and reuse existing radio
    sessions; nothing new is transmitted.
    - Channel heatmap (Kanal Haritası): a per-channel (1-13) occupancy bar
    chart derived from the monitor's deduped AP list, showing AP count and
    strongest RSSI per channel. New c6_link_monitor_channel_stats().
    - Frame-type statistics (Çerçeve İstat): cumulative beacon / probe-req /
    probe-resp / other-mgmt / data / control tally counted in the
    promiscuous callback. Widens the promiscuous filter to MGMT|DATA|CTRL
    and adds c6_link_monitor_frame_stats()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
2026-09-27 Add SESSION handoff docs; record flash + new passive features
    Adds the five SESSION_*.md onboarding/status documents and updates
    SESSION_04 to reflect current reality: the channel map, frame-stats,
    and BLE beacon-decode features are done, built warning-free, and
    flashed to the device over COM7 (on-device visual verification still
    pending). Marks those three backlog items complete; MIFARE sector map
    (needs RC522) and IR protocol expansion remain.
2026-09-27 Fix stack-overflow crash in BLE scan screens
    Adding the beacon fields grew c6_bt_device_t, so the 32-entry
    devices[] / aps[] scratch arrays on the main task stack pushed it past
    its bounds, faulting inside snprintf (Guru Meditation "Stack protection
    fault" in _vfprintf_r) the moment BLE Keşif or BT Tara was opened. Move
    those large per-screen arrays to static storage (safe: entered only from
    the single-threaded menu loop). Also harden decode_beacon against a null
    or too-short advertisement payload.
    Verified on hardware: BLE Keşif and BT Tara now open without resetting.
    [main.c, radio_ble.c]
2026-09-27 Add BLE radar; fix stack-overflow crashes and keyboard/boot input
    New feature -- BLE Radar (Bluetooth menu): locates nearby BLE devices
    with no extra hardware. The user calibrates bearings with one timed
    360 turn (start/stop with RIGHT), after which the radar stays live:
    distances update continuously from smoothed RSSI as the user walks
    (blips slide toward center when closer), bearings stay locked from the
    calibration turn, targets are ordered nearest-first, and stale targets
    fade. UP recalibrates, LEFT exits. Adds pixel/line/circle drawing
    primitives to the display driver to render it.
    Crash fixes (all were main-task stack overflows -> "Stack protection
    fault" reboots; the default 3584-byt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
    [buttons.c, buttons.h, display.c, display.h, main.c, qrcode.c]
2026-09-27 BLE scan: active scan for names, MAC fallback, named+nearest sort; keyboard ENTER label
    - Switch BLE discovery to active scan so devices return their name in a
    scan response (headphones, watches, etc. now show names; passive scan
    rarely saw any). Emits small scan-request packets, like a phone does.
    - Show the last 3 MAC bytes for devices that advertise no name, so every
    entry is distinguishable instead of all reading "(adsız)".
    - Sort the BT scan list named-first, then nearest-first by RSSI within
    each group; radar targets fall back to MAC when unnamed too.
    - Rename the keyboard's "^" confirm cell to "ENT" and update the hint row
    so the finish/enter action is obvious.
    Verified on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
2026-09-27 Add passive recon tools: probe-request capture, BLE device-kind, weak-AP flag
    Three receive-only additions under Hacking / BT scan; all read what devices
    already broadcast and transmit nothing.
    - Probe-request capture (Hacking > Probe Yakala): lists distinct SSIDs that
    nearby clients name in probe requests, with a per-SSID sighting count.
    Stores no device addresses. New c6_link_monitor_probe_poll() plus probe
    parsing in the promiscuous callback; reset each monitor session.
    - BLE device-kind guess: labels each scanned BLE device (Kulaklik, Saat,
    Kalp, HID, Apple, Google, Samsung, ...) from advertised 16-bit service
    UUIDs, the appearance field, and the manufacturer company id. Shown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
    [c6_link.c, c6_link.h, main.c, radio_ble.c]
2026-09-27 Sort all scan lists nearest-first; refresh README and SESSION docs
    - WiFi scan and WiFi monitor lists now sort nearest-first by RSSI, matching
    the BLE scan and radar lists, so every scan screen reads closest-first.
    - README: document the current working feature set (QR, channel map, frame
    stats, probe capture, active BLE scan with device-kind, BLE radar, weak-AP
    flag), correct the prototype status to "runs on hardware", and note the
    2.4 GHz-only limit.
    - SESSION_03/04: update menus, mark the added features done, record the
    stack-overflow / boot-RFID / keyboard-LEFT fixes and the mkf_verify sync
    pitfall, and refresh the git history.
    [main.c]
2026-09-28 Add WiFi Radar; resolve UP/RC522 and motor/PRESS GPIO conflicts
    WiFi Radar (Hacking menu) mirrors BLE Radar's calibrated-turn direction
    mapping for nearby Wi-Fi access points, built on the existing channel-hop
    monitor's AP list.
    Also resolves two long-standing GPIO double-bookings in source: joystick UP
    moves from GPIO6 to GPIO16 (freeing GPIO6 for RC522 MISO), and the vibration
    motor moves from GPIO3 to GPIO15 (freeing GPIO3 for the joystick centre
    press). Both new pins are free, non-strapping GPIOs on this board. Physical
    rewiring still required before RC522 or the motor can be used.
    [buttons.c, hardware_profile.h, main.c, vibration.c]
2026-09-28 Fix GPIO16/17/14: not physical pins on the actual DEV-KIT-NX board
    Board photo confirms the Waveshare ESP32-C6-DEV-KIT-NX header only breaks
    out IO0-IO13, IO15 and IO18-IO23 (plus TXD/RXD/3V3/RST/5V/GND) -- GPIO14,
    16 and 17 have no header pin at all. The previous commit's UP-conflict fix
    (GPIO6 -> GPIO16) and the pre-existing IR pins (14/17) were therefore never
    wirable.
    Corrected: joystick UP now uses GPIO13 (unclaimed, non-strapping). IR
    receive/transmit move to GPIO4/GPIO0, the only pins left unclaimed on this
    board; both are boot-strapping pins, flagged as unverified on hardware.
    [hardware_profile.h, ir_driver.c]
2026-09-28 Fix CI: stub FreeRTOS headers for host tests; fix keyboard hold re-arm bug
    Host tests broke back at 2cd36f67 when buttons.c gained FreeRTOS includes
    (vTaskDelay in buttons_wait_all_released) with no matching mock header in
    tests/stubs, so test_buttons_keyboard.c failed to compile in CI. Added
    minimal freertos/FreeRTOS.h and freertos/task.h stubs (pdMS_TO_TICKS,
    no-op vTaskDelay).
    Fixing the build surfaced a second, real bug the outdated test also masked:
    after a long-hold RIGHT/LEFT fires PRESS/BACK, the key was still read as
    down on the next poll, so it re-armed as a fresh short press and fired a
    bogus RIGHT/LEFT the moment the user finally released it. Added a
    "consumed" latch per key tha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
    [buttons.c, test_buttons_keyboard.c]
2026-09-28 Add button-event-counter debug screen; RC522 wiring map doc
    Diagnosing a bug where a single UP press was registering 4-5 times: added
    a temporary "Buton Sayaç [DEBUG]" screen (main menu, bottom) that counts raw
    button events per key so a phantom/bounce issue can be confirmed on-device
    without a serial monitor. Confirmed the UP (GPIO13) lead bounces well past
    what a 100ms debounce can absorb, pointing at a loose jumper contact rather
    than a debounce-tunable software issue; RC522 wiring is suspected to have
    the same root cause and was disconnected for now (BOARD_HAS_RC522 back to 0).
    Also added WIRING_MAP_RC522.md, a wiring reference for soldering the RC522
    leads (which pins are RC522-only v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
    [main.c]
2026-09-28 Move joystick UP back to GPIO6: GPIO13 is the C6's native USB D+
    Putting UP on GPIO13 disabled the native USB port (ESP-IDF clears the USB
    pad enable when GPIO12/13 are reconfigured) and the pin produced 4-5
    phantom UP presses per real press, which no debounce fixed. Back on GPIO6
    one press registers once. RC522 stays disabled; its MISO now needs a pin
    other than GPIO6.
    Also corrects docs: GPIO15 and GPIO4 are strapping pins, and TXD/RXD are
    GPIO16/17 (UART0 to the CH343), not missing pins.
    [buttons.c, hardware_profile.h, ir_driver.c]
2026-09-28 UI polish + pin/wiring rework: WiFi radar, menu icons, boot splash
    Consolidates the work since 8beb7a05:
    - WiFi Radar built on the shared multi-phase radar engine (spin
    calibration -> live bearing -> optional triangulation fix), mirroring
    the BLE radar. PRESS dropped from radar cycling (floating GPIO3).
    - Menu icons for every top-level entry, redrawn to fit inside the 16px
    row (no vertical bleed into adjacent rows); WiFi icon uses upward
    half-arcs instead of full rings.
    - Animated boot splash (expanding rings + ERDEMFLIP wordmark).
    - Pin map reworked for the Waveshare ESP32-C6-DEV-KIT-NX header: UP=GPIO6,
    vibration=GPIO1, RDM6300 RX=GPIO15, IR RX=GPIO4/TX=GPIO0. Never use
    GPIO12/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
    [buttons.c, c6_link.c, c6_link.h, display.c, hardware_profile.h, main.c, menu.c, menu.h]
2026-09-29 Battery gauge, radar sonar-ping animation, menu render fixes
    - Battery fuel gauge (feedback/battery.c/.h): ADC oneshot on GPIO3 through
    a 2:1 divider, LiPo discharge-curve percentage, and a battery badge in
    the menu banner's right corner. Floating (unwired) pin is detected via
    sample-spread + threshold and shown as "--" instead of a value that
    jumped on every redraw. GPIO3 pull-up disabled.
    - Radar screens: a continuous sonar-style "ping" ring expands out from the
    centre on every radar_render(), tied to wall-clock time.
    - menu.c: restored the correct icon + UTF-8 truncation render path after it
    had been overwritten by an out-of-tree edit.
    - CMakeLists: register feedback/battery.c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
    [battery.c, battery.h, main.c]
2026-09-30 Add combined BLE+probe walk-around radar; clean up injected corruption
    - New "Birlesik Radar" (combined radar): places BLE devices and Wi-Fi
    probe-request devices on one screen by smoothed RSSI distance, with a
    hot/cold walk-around search (trend arrow + metal-detector beep that
    speeds up as the selected target gets closer) and RSSI+angle nearest
    correlation between a BLE device and the probes at the same spot, shown
    with a connecting line and a match ripple. A = full detail page listing
    the device's info and its correlated probe(s).
    - Per-device probe capture (c6_probe_dev_t) added to the passive monitor:
    keys probe requests by source MAC with RSSI, receive-only.
    - BLE analyzer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
2026-09-30 README: document full current feature set
    - Expand the capability table with each menu's exact item labels and add the
    battery gauge, buzzer/haptic feedback and boot splash.
    - Document Birlesik Radar (combined BLE + Wi-Fi-probe walk-around radar):
    hot/cold distance-by-RSSI, closer/farther trend + metal-detector beep,
    nearest-match correlation with connecting line and ripple, A = detail page,
    and its honest limits (heuristic correlation, angle is not a bearing).
    - Note the BLE analyzer privacy view (address type + company ID).
    - Update the pin table: GPIO3 is now the battery ADC (was centre press),
    GPIO1 buzzer bench-tested; add combined-radar controls. Keep all validation
    boundar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
2026-09-30 README: translate all prose to English
    The device UI is Turkish; the README now reads fully in English, with each
    Turkish on-screen menu/item label kept and glossed with its English meaning
    (e.g. "WiFi Ağım" = my network). Recon-tool bullets and the combined-radar
    entry now lead with the English name. No content or capability changes.
2026-09-30 KNOWN_ISSUES: reconcile stale hardware notes with current C6 build (Round 29)
    A scan for open issues found no unresolved code defect (every prior round is
    fixed/accepted/false-alarm and the tree builds clean), but several Round 27/28
    hardware claims had gone stale after the move to the ESP32-C6-DEV-KIT-NX with
    a direct-GPIO Pico-LCD-1.3 plus the new battery gauge. Corrected against the
    authoritative source in main/:
    - No TCA9554 button expander any more; buttons are direct active-low GPIO
    (UP=6, DOWN=11, LEFT/BACK=23, RIGHT=22, A=10, PRESS=3).
    - Motor/buzzer is GPIO1 (was mis-noted as GPIO3).
    - GPIO3 is now the battery ADC (ADC1_CH3, 2:1 divider); gauge was undocumented.
    - IR is RX=GPIO4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
2026-10-05 Add captive-portal awareness screen, BLE spam UI, and hardware build guides
    Firmware:
    - net/captive_portal.{c,h} + captive_cat_img.h: password-less SoftAP with
    embedded DNS + HTTP serving a single honest awareness page (image + joke +
    optional message box + "don't trust every WiFi" warning). No credential
    harvesting; messages held in RAM and read behind a password-protected page.
    Wired into main.c, CMakeLists.txt (esp_http_server), and c6_link.
    - main.c / radio_ble.c: BLE spam action screen and loop.
    - WIRING_MAP_RC522.md: wiring updates.
    hardware/: perfboard + soldering guides, netlist, README.
    .gitignore: exclude local .claude/ tooling config.
2026-10-05 Organize root docs into docs/{sessions,hardware,planning}
    Move the loose top-level markdown out of the repo root into grouped
    subfolders, keeping README.md, KNOWN_ISSUES.md and WIRING_MAP_RC522.md
    at the root as the entry points:
    - docs/sessions/ SESSION_00..04
    - docs/hardware/ HARDWARE_INTEGRATION_PLAN, HARDWARE_TEST_MATRIX,
    C6_STANDALONE_HARDWARE_PLAN, MCU_ARCHITECTURE_DECISION
    - docs/planning/ CAPABILITY_AND_THREAT_ASSESSMENT, GORSEL_PROMPTLARI,
    ERDEM_SATIN_ALINACAKLAR
    Updated all references to the new paths: README.md links, the
    cross-folder links/prose in the moved docs, hardware/LEHIM_REHBERI.md,
    and the source comments in main/rfid/rc522.c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
    [display.c, rc522.c]
2026-10-14 Wiring audit fixes, 3D viewer, perfboard plan and compact stack
    - Fix R4 to 1k, GPIO3 battery ADC no longer pulled up by buttons_init
    - Correct stale pin notes in docs and headers
    - Add 3d/ interactive viewer + GLB export
    - Add perfboard step-by-step plan generator (incl. power chain stage)
    - Add compact stacked 3D layout and verification notes
2026-10-14 Cross-check orders against wiring plan: KY-005, 2N2222A pinout, RDM6300 TX level, missing parts
2026-10-14 Update board model (WROOM-1, 51.8x25.4), plan outline, notes; add page screenshots to README
2026-10-15 Bare-stack hardware plan: 3D model, hole-by-hole plan, drawings, README refresh
    - bare_stack.html: 3D model of the enclosure-free single-plate build with
    clash check, hole-plan overlay and assembly animation
    - perfboard_plan_bare.html / make_plan_bare.py: 46x18 hole plan, 64 wires,
    nine stages (English); markdown export
    - bare_board_top*.svg via make_board_drawing.py
    - README: physical build section, new screenshots, RDM6300 divider note;
    hardware/README: current plan first, older pages marked as historical
    - remove superseded screenshots
